onionsat-pcbs/gaia-obc/readme.txt

Kicadben az outline importálása: File -> Import -> Graphics

import scale: 1
dxf defult line width: 0.2mm
dxf defult units: millimetres
place at: x-eld ki
layer: edge cuts
group: kikapcsolva
fix discontinuities: kikapcsolva
