onionsat-pcbs/gaia-obc/outline.dxf

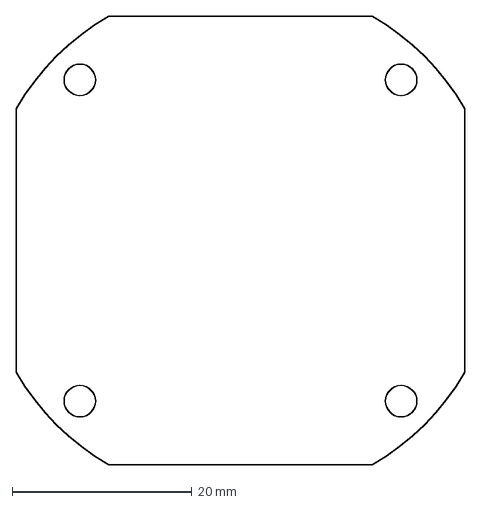
[picture p1: CAD file, 2025-06-25]
outline.dxf
50.0 x 50.0 mm
