onionsat-pcbs/gaia-obc/3dmodels/OLED-SMD_ST7735S.step

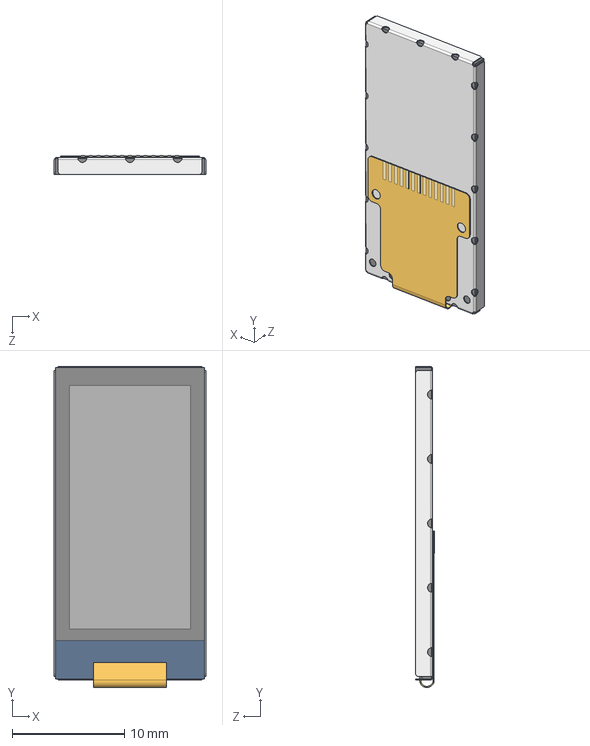
[picture p2: CAD file, 2025-12-01]
3dmodels/OLED-SMD_ST7735S.step
13.5 x 28.6 x 1.65 mm
