onionsat-pcbs/gaia-obc/3dmodels/SMD_16P-L16.0-W16.0-P2.00.step

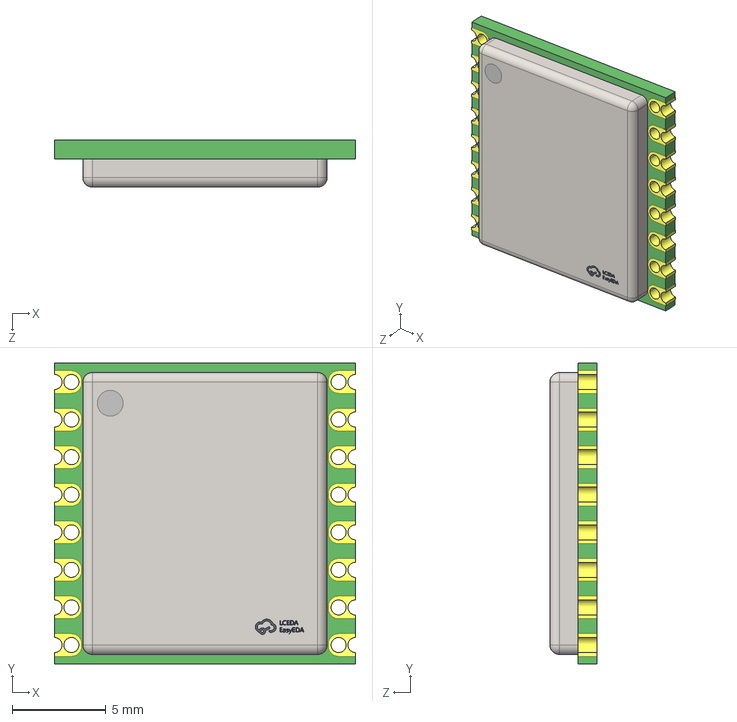
[picture p3: CAD file, 2025-12-01]
3dmodels/SMD_16P-L16.0-W16.0-P2.00.step
16.0 x 16.0 x 2.51 mm
