onionsat-pcbs/gaia-obc/3dmodels/CD-PA1616D.STEP

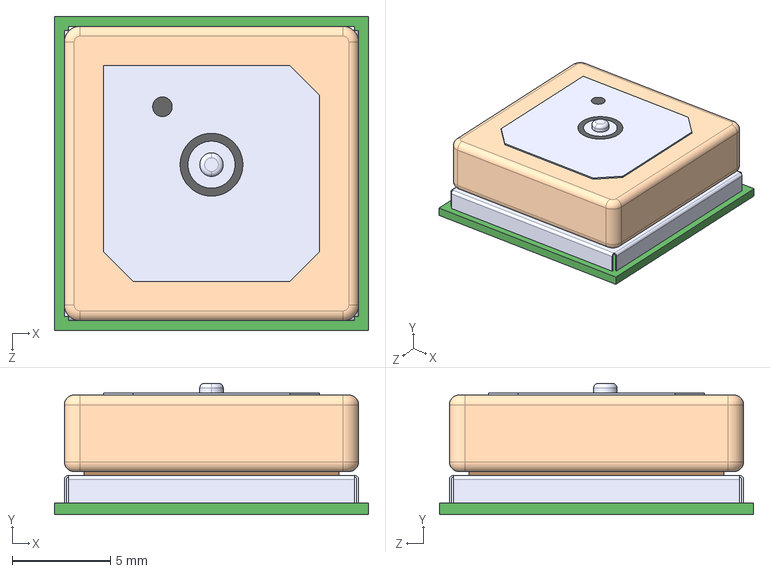
[picture p4: CAD file, 2025-12-01]
3dmodels/CD-PA1616D.STEP
16.0 x 6.70 x 16.0 mm
