onionsat-pcbs/gaia-obc/3dmodels/KEY-SMD_4P-L3.1-W3.1-P2.00-LS4.0.step

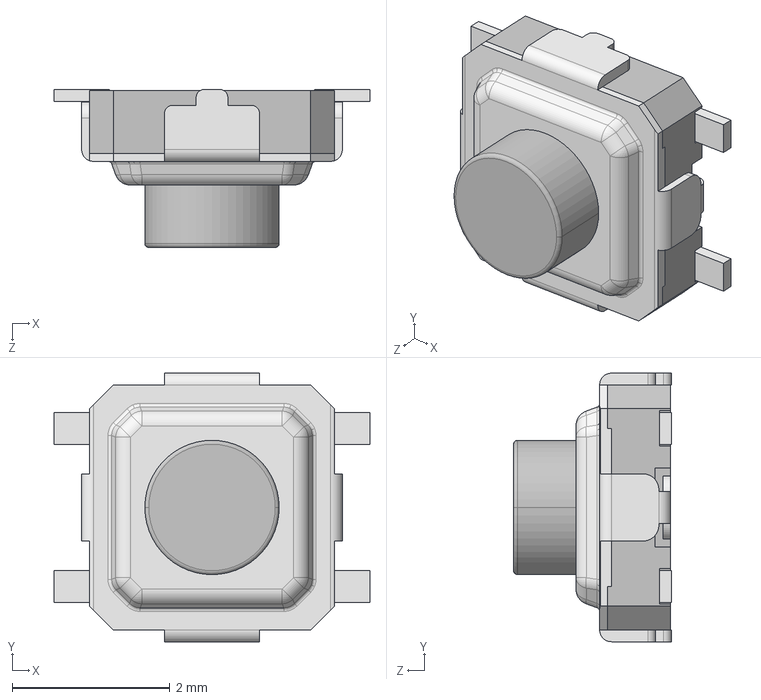
[picture p5: CAD file, 2025-12-01]
3dmodels/KEY-SMD_4P-L3.1-W3.1-P2.00-LS4.0.step
4.00 x 3.40 x 2.00 mm
