onionsat-pcbs/gaia-obc/3dmodels/INA3221.STEP

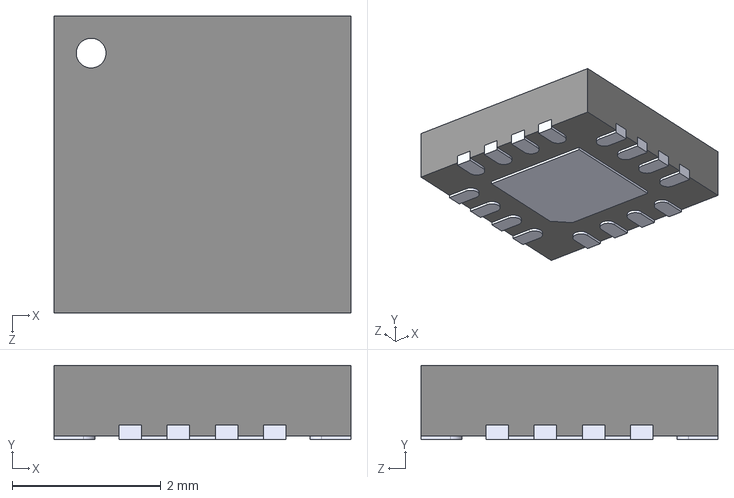
[picture p6: CAD file, 2025-12-01]
3dmodels/INA3221.STEP
4.00 x 1.00 x 4.00 mm
