onionsat-pcbs/gaia-obc/3dmodels/KEY-SMD_L4.0-W3.0-LS4.9.step

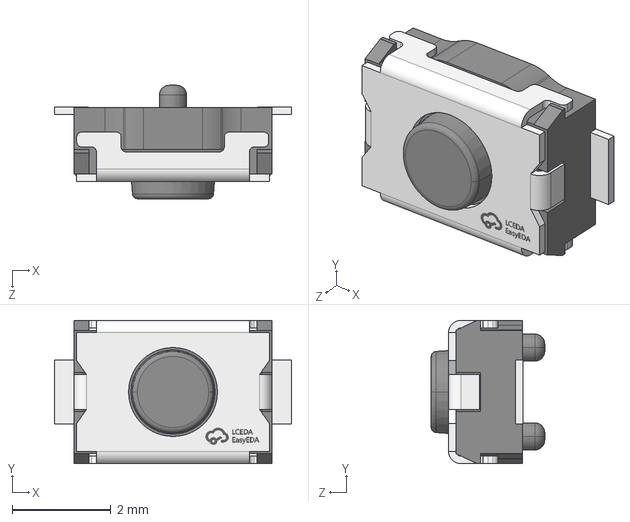
[picture p7: CAD file, 2025-12-01]
3dmodels/KEY-SMD_L4.0-W3.0-LS4.9.step
4.80 x 2.90 x 2.30 mm
