onionsat-pcbs/gaia-obc/3dmodels/ESP32-S3-PICO-1-N8R2.STEP

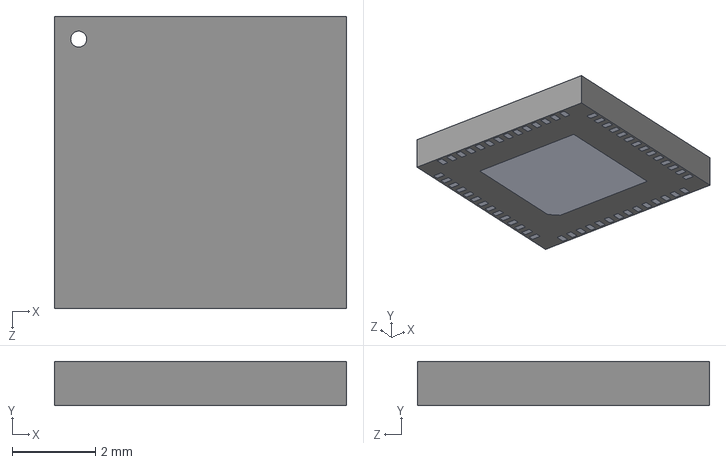
[picture p8: CAD file, 2025-12-01]
3dmodels/ESP32-S3-PICO-1-N8R2.STEP
7.00 x 1.06 x 7.00 mm
