onionsat-pcbs/gaia-obc/3dmodels/SW-SMD_MS-22D28-G020.step

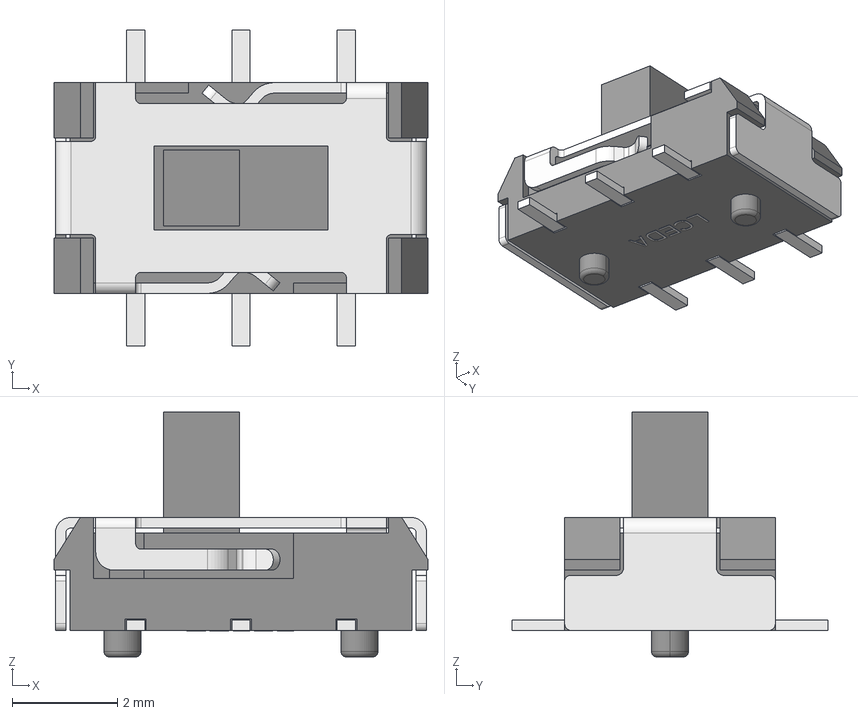
[picture p9: CAD file, 2025-12-01]
3dmodels/SW-SMD_MS-22D28-G020.step
7.10 x 6.00 x 4.65 mm
