onionsat-pcbs/gaia-obc/3dmodels/RFM95W-868S2.STEP

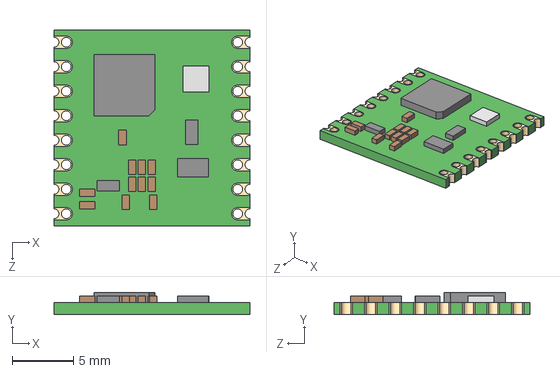
[picture p10: CAD file, 2025-12-01]
3dmodels/RFM95W-868S2.STEP
16.0 x 1.80 x 16.0 mm
