onionsat-pcbs/gaia-obc/3dmodels/antenna.step

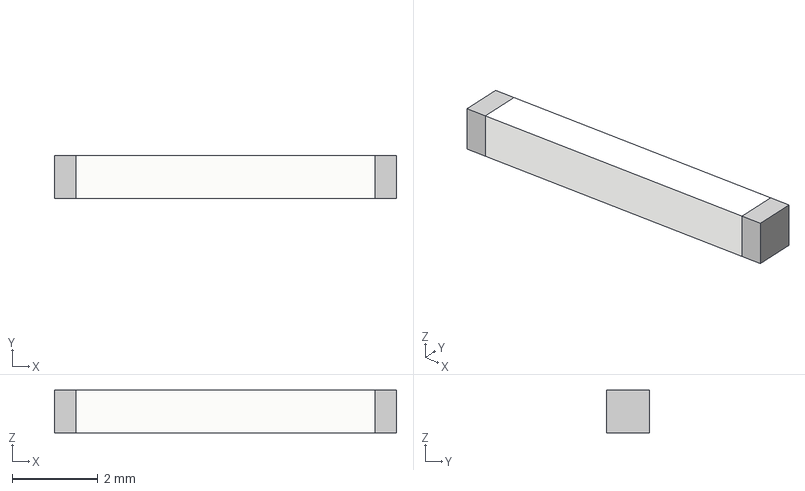
[picture p11: CAD file, 2025-12-01]
3dmodels/antenna.step
8.00 x 1.00 x 1.00 mm
