onionsat-pcbs/gaia-obc/3dmodels/BUZ-SMD_3P-L5.0-W5.0-H2.0-P3.50.step

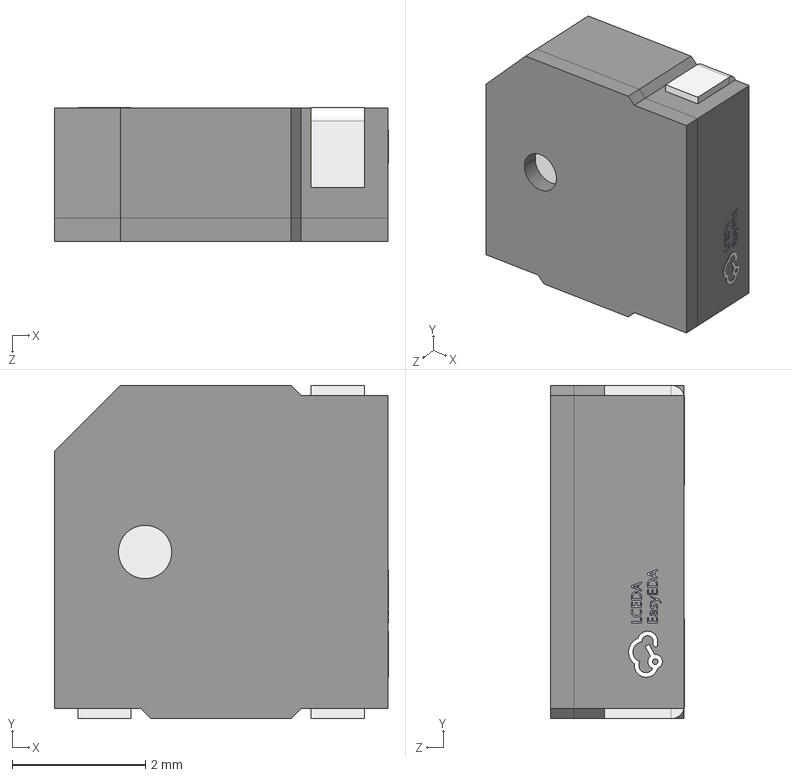
[picture p12: CAD file, 2025-12-01]
3dmodels/BUZ-SMD_3P-L5.0-W5.0-H2.0-P3.50.step
5.01 x 5.00 x 2.01 mm
