onionsat-pcbs/gaia-obc/3dmodels/BME280.STEP

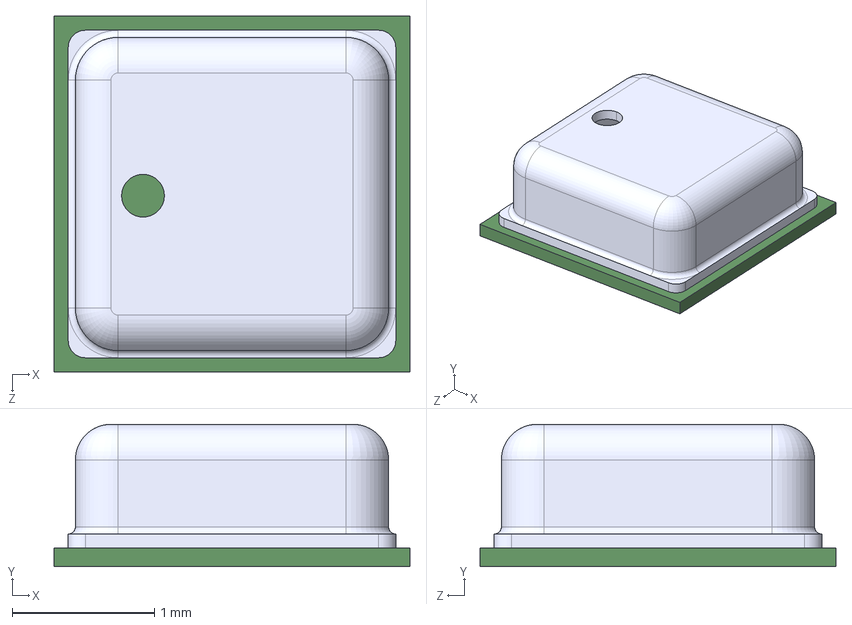
[picture p13: CAD file, 2025-12-01]
3dmodels/BME280.STEP
2.50 x 1.00 x 2.50 mm
