onionsat-pcbs/gaia-obc/3dmodels/USB4216-03-A.stp

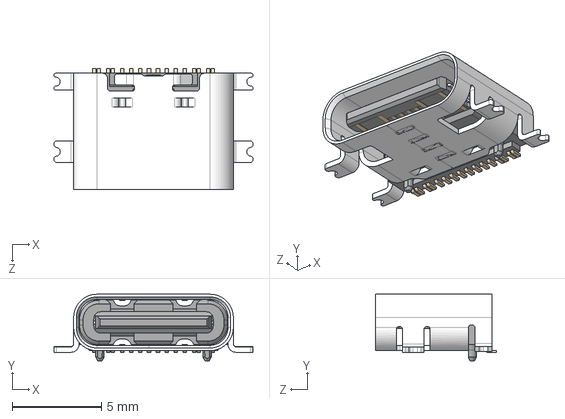
[picture p14: CAD file, 2025-12-01]
3dmodels/USB4216-03-A.stp
11.1 x 3.73 x 6.75 mm
USB4216 Shell
USB4216 Housing&Terminal
