onionsat-pcbs/gaia-obc/3dmodels/TFM201610GHM-1R0MTAA.stp

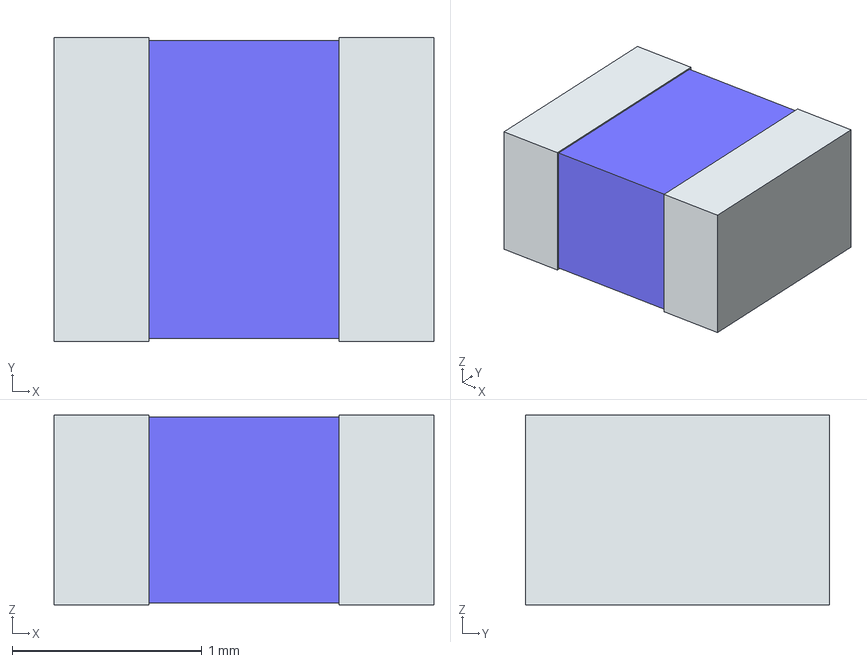
[picture p15: CAD file, 2026-02-01]
3dmodels/TFM201610GHM-1R0MTAA.stp
2.00 x 1.60 x 1.00 mm
term1
term2
