onionsat-pcbs/gaia-obc/3dmodels/MAX77816AEWP_T.step

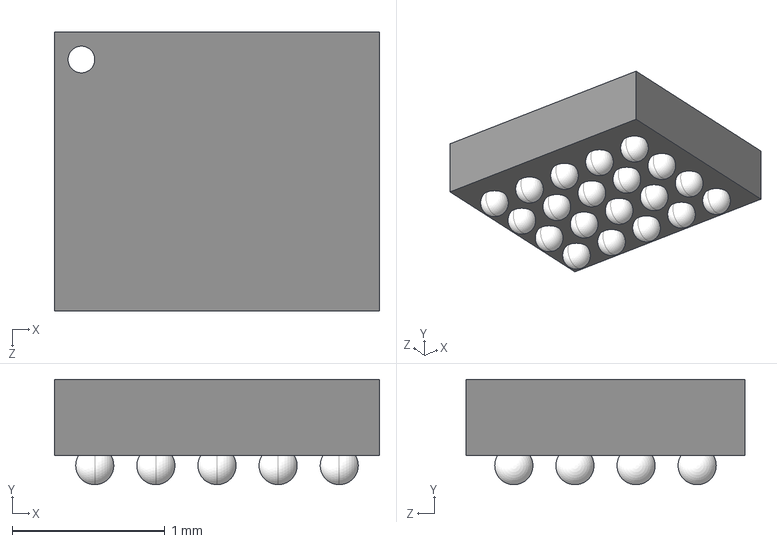
[picture p16: CAD file, 2025-12-30]
3dmodels/MAX77816AEWP_T.step
2.13 x 0.69 x 1.83 mm
