onionsat-pcbs/gaia-obc/3dmodels/MAX17048G-T10.STEP

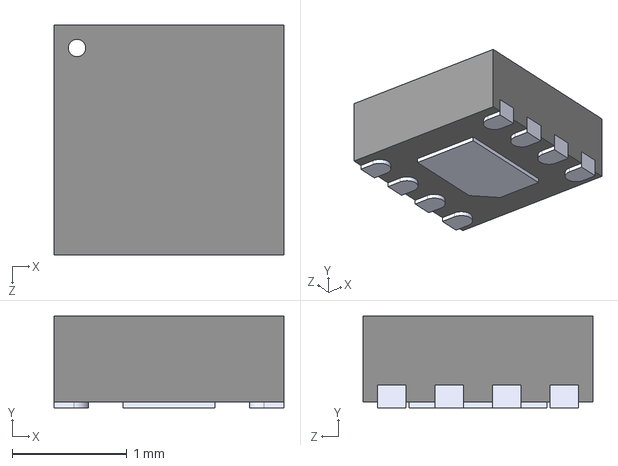
[picture p17: CAD file, 2025-12-01]
3dmodels/MAX17048G-T10.STEP
2.00 x 0.8 x 2.00 mm
