onionsat-pcbs/gaia-obc/schematics/gaia_obc_schematic_rev1.4.pdf

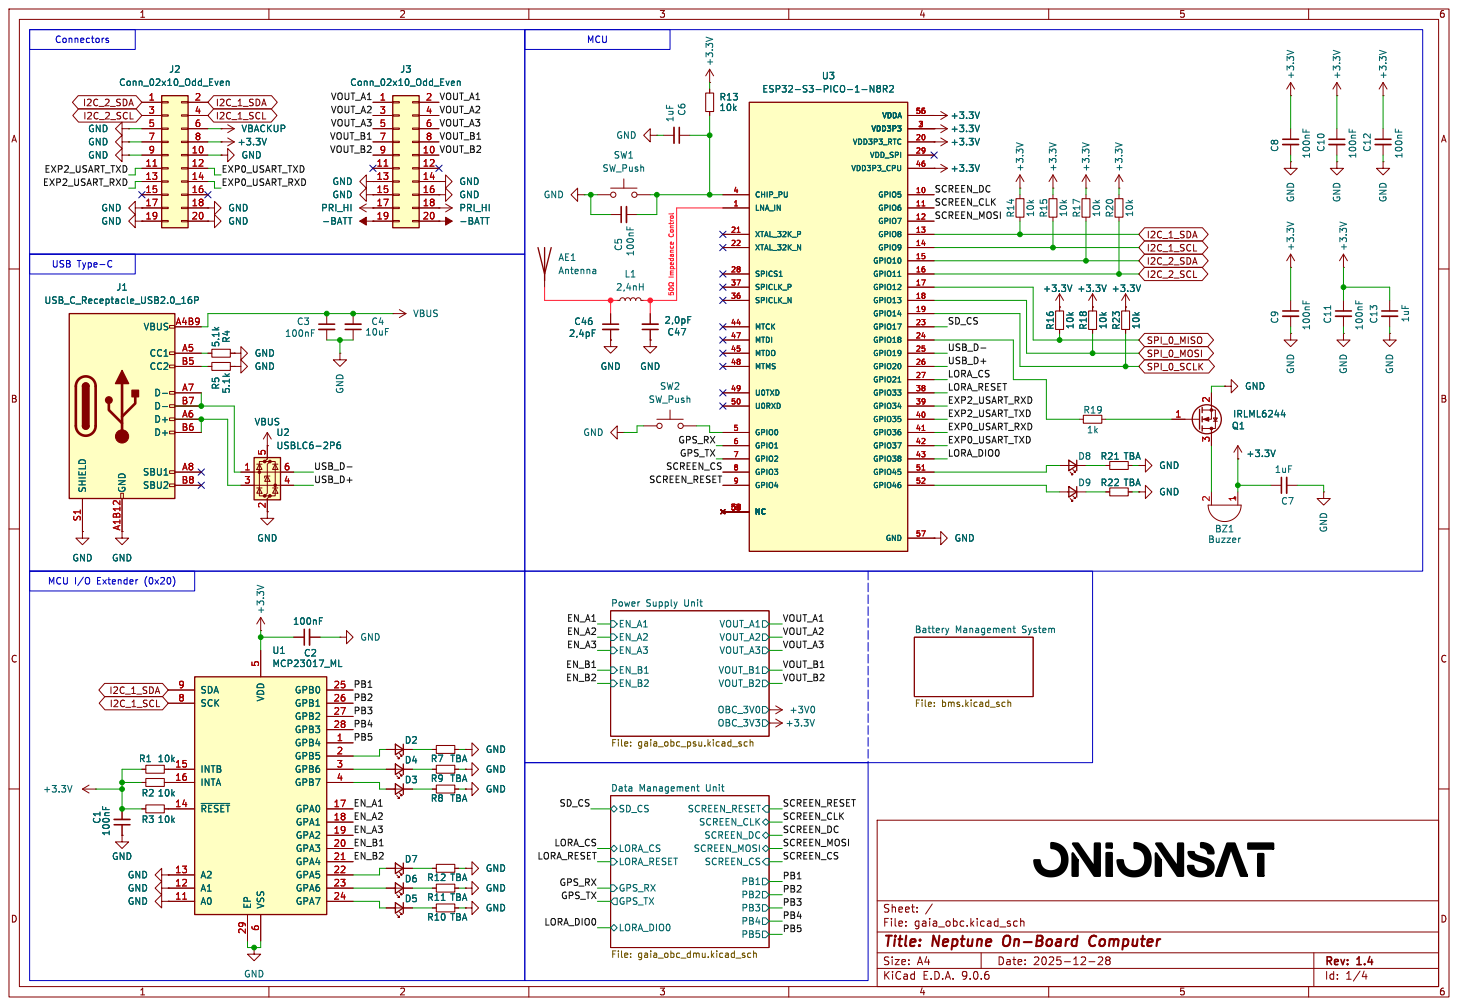
[picture p18: page 1]

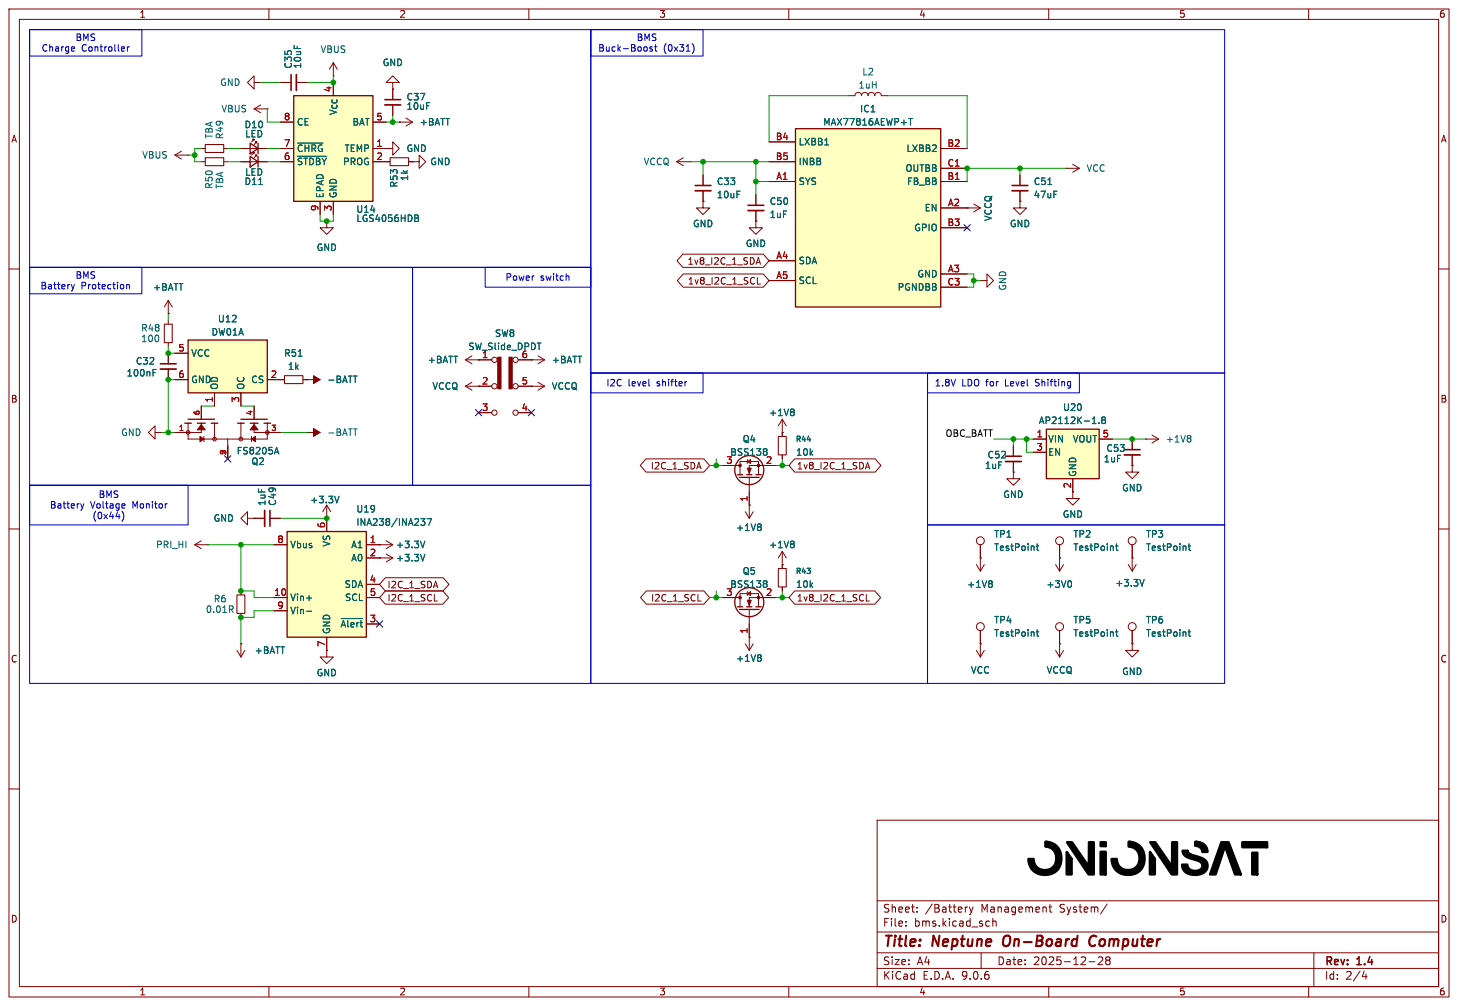
[picture p19: page 2]

+BATT GND R531k C35 10uF TBA R49 GND

3 BAT 5 TEMP 1 PROG 2 +BATT GND R531k C35 10uF D10

7 A1 1 A0 2 SDA 4 SCL 5 ~{Alert}3 GND

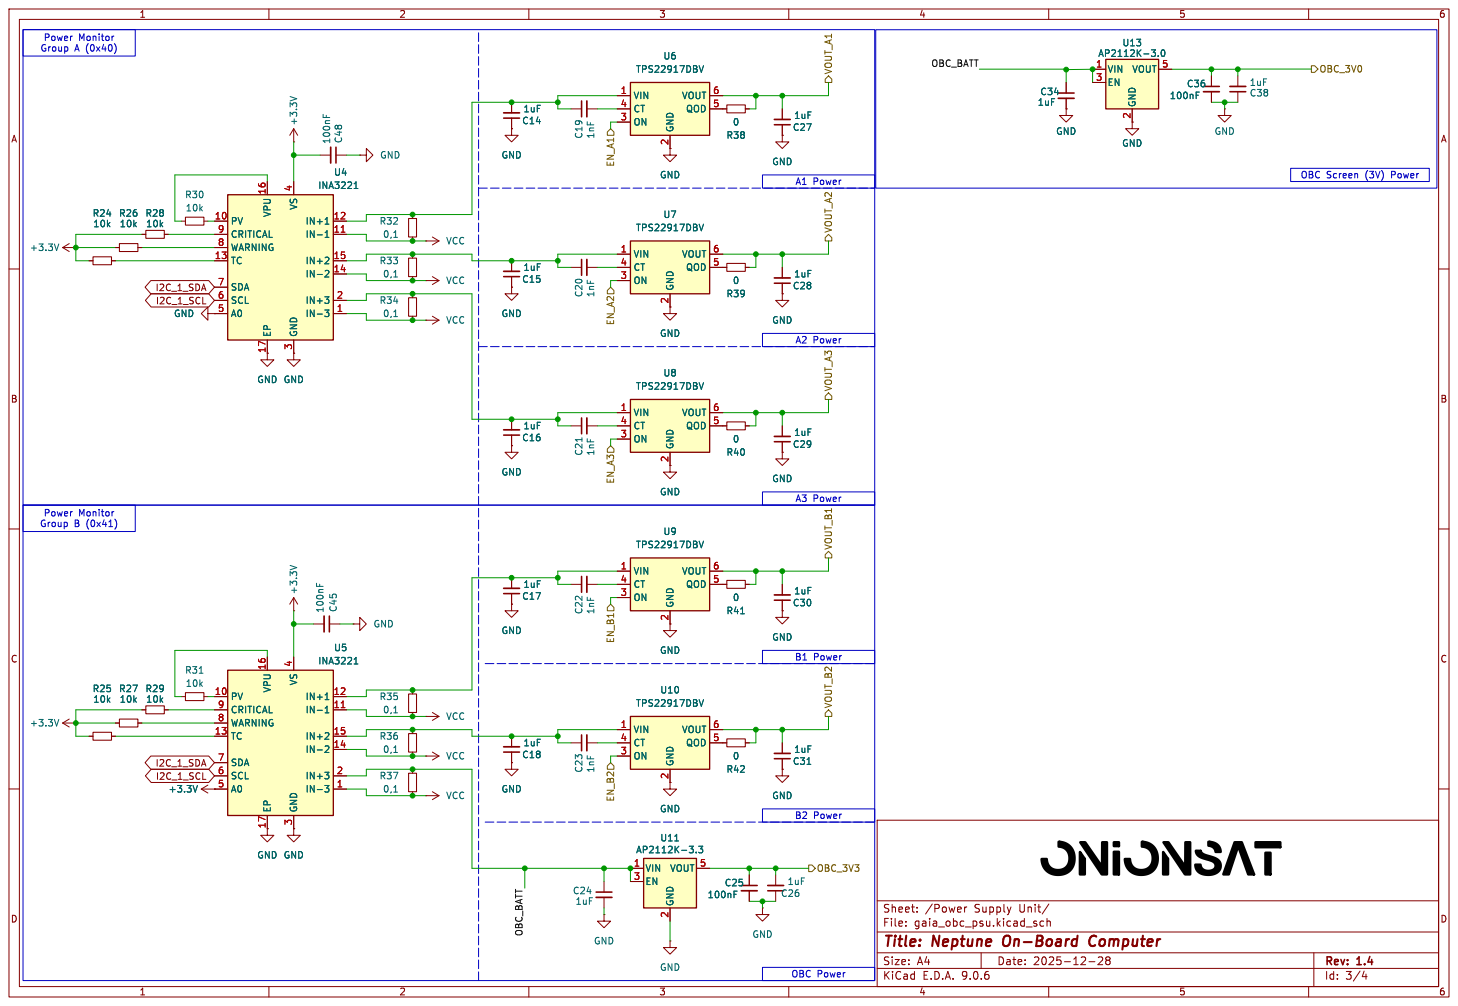
[picture p20: page 3]

B2 Power OBC Power B1 Power Power Monitor Group B (0x41)

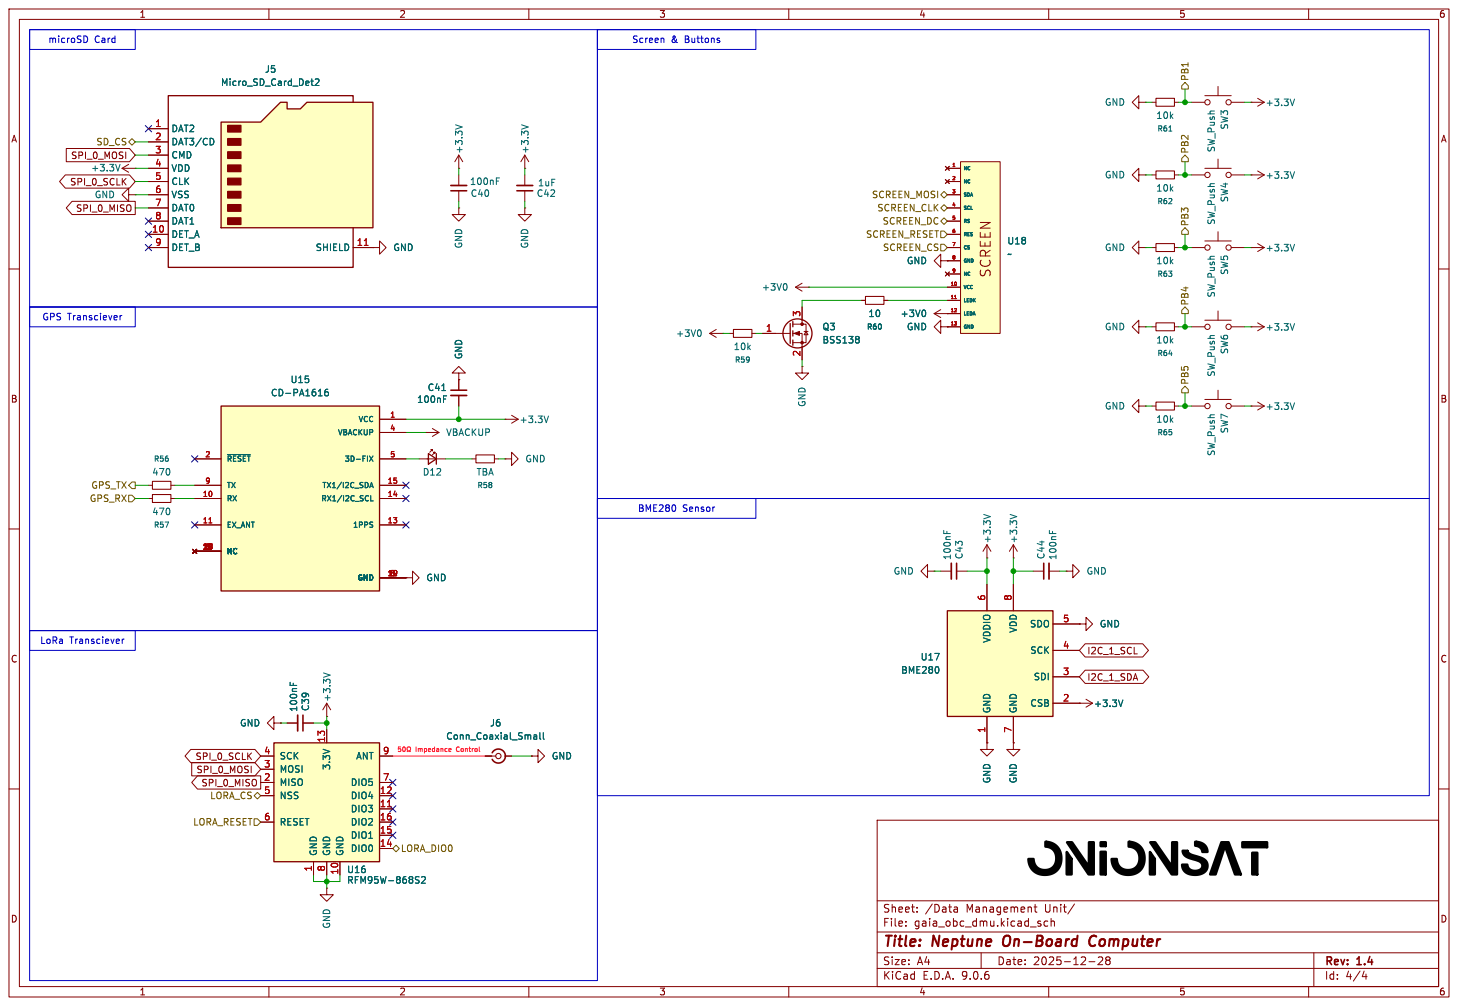
[picture p21: page 4]
