onionsat-pcbs/gaia-obc/schematics/gaia_obc_schematic_rev1.3.pdf

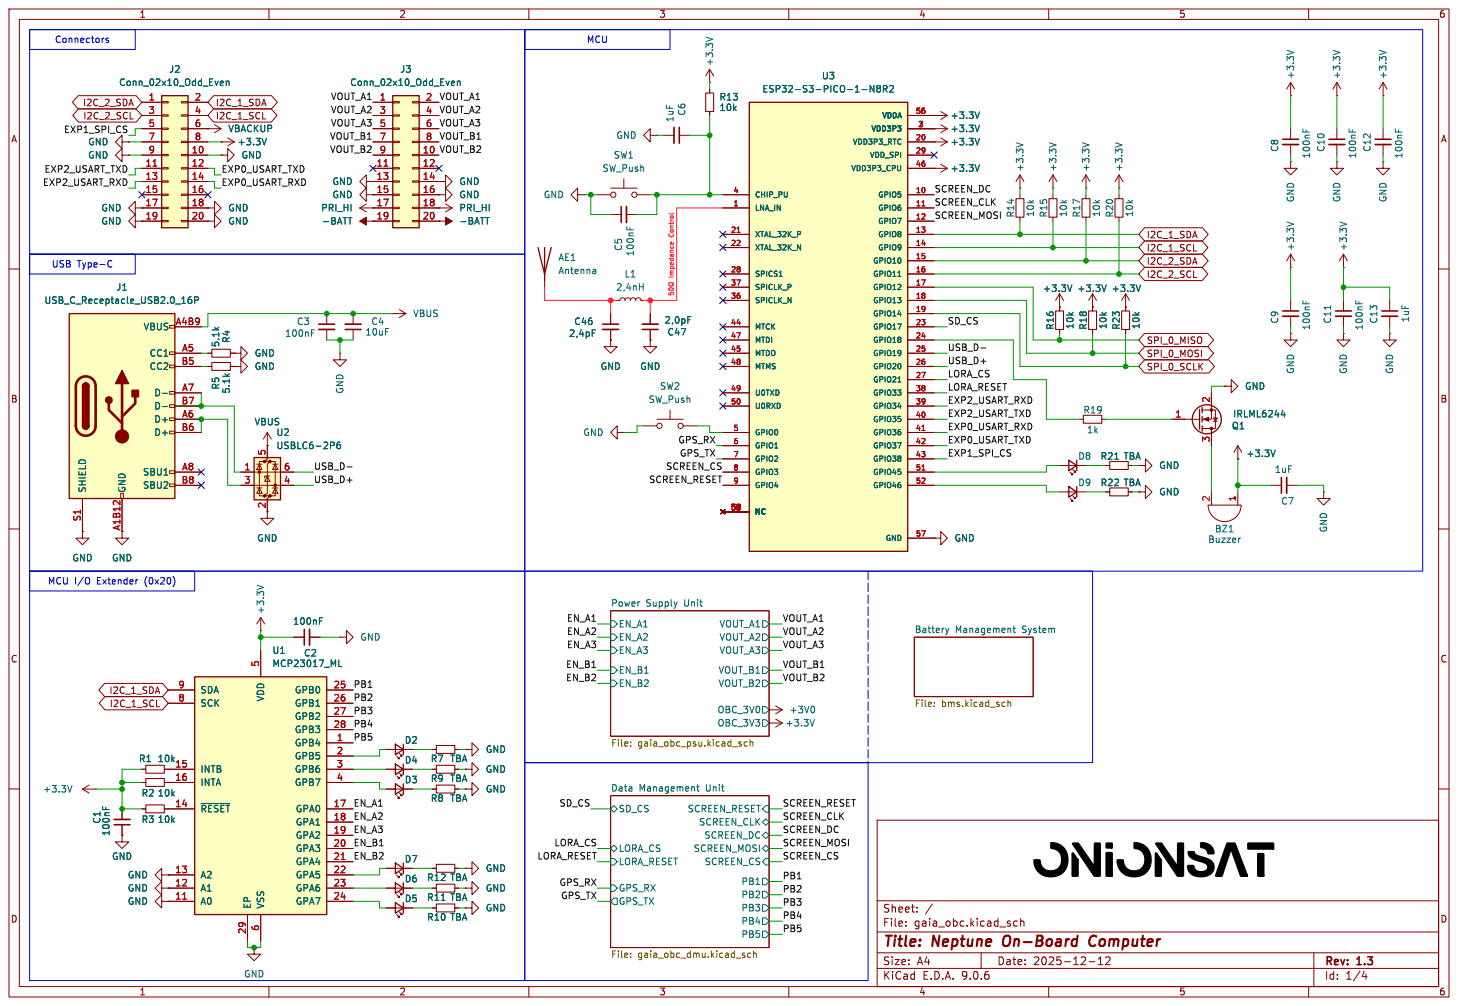
[picture p22: page 1]

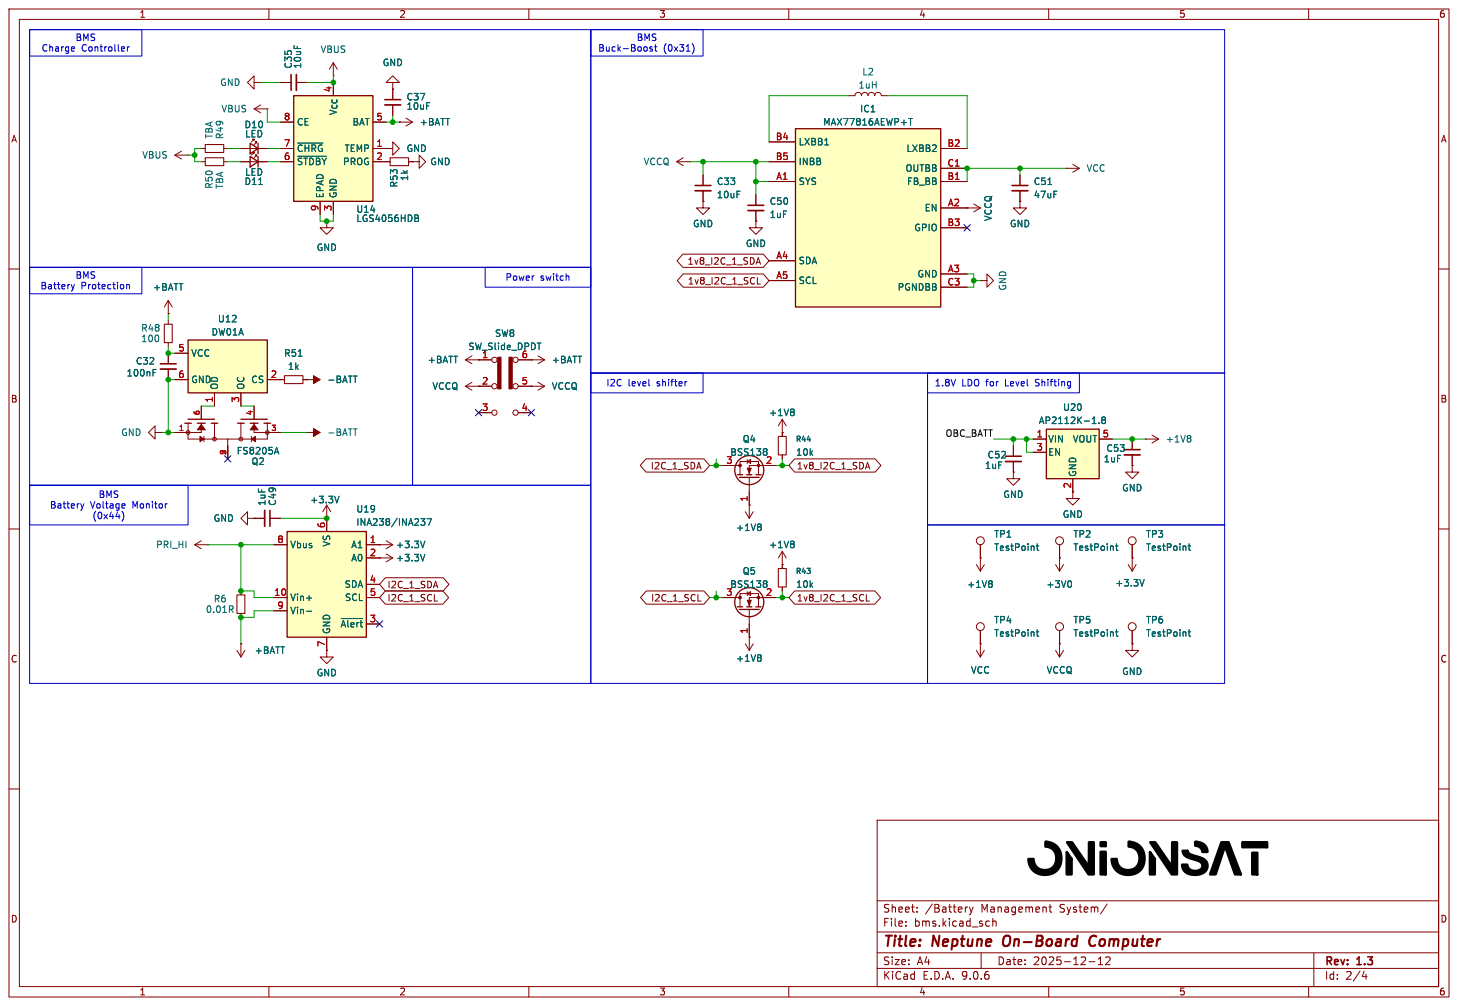
[picture p23: page 2]

1.8V LDO for Level Shifting Power switch BMS

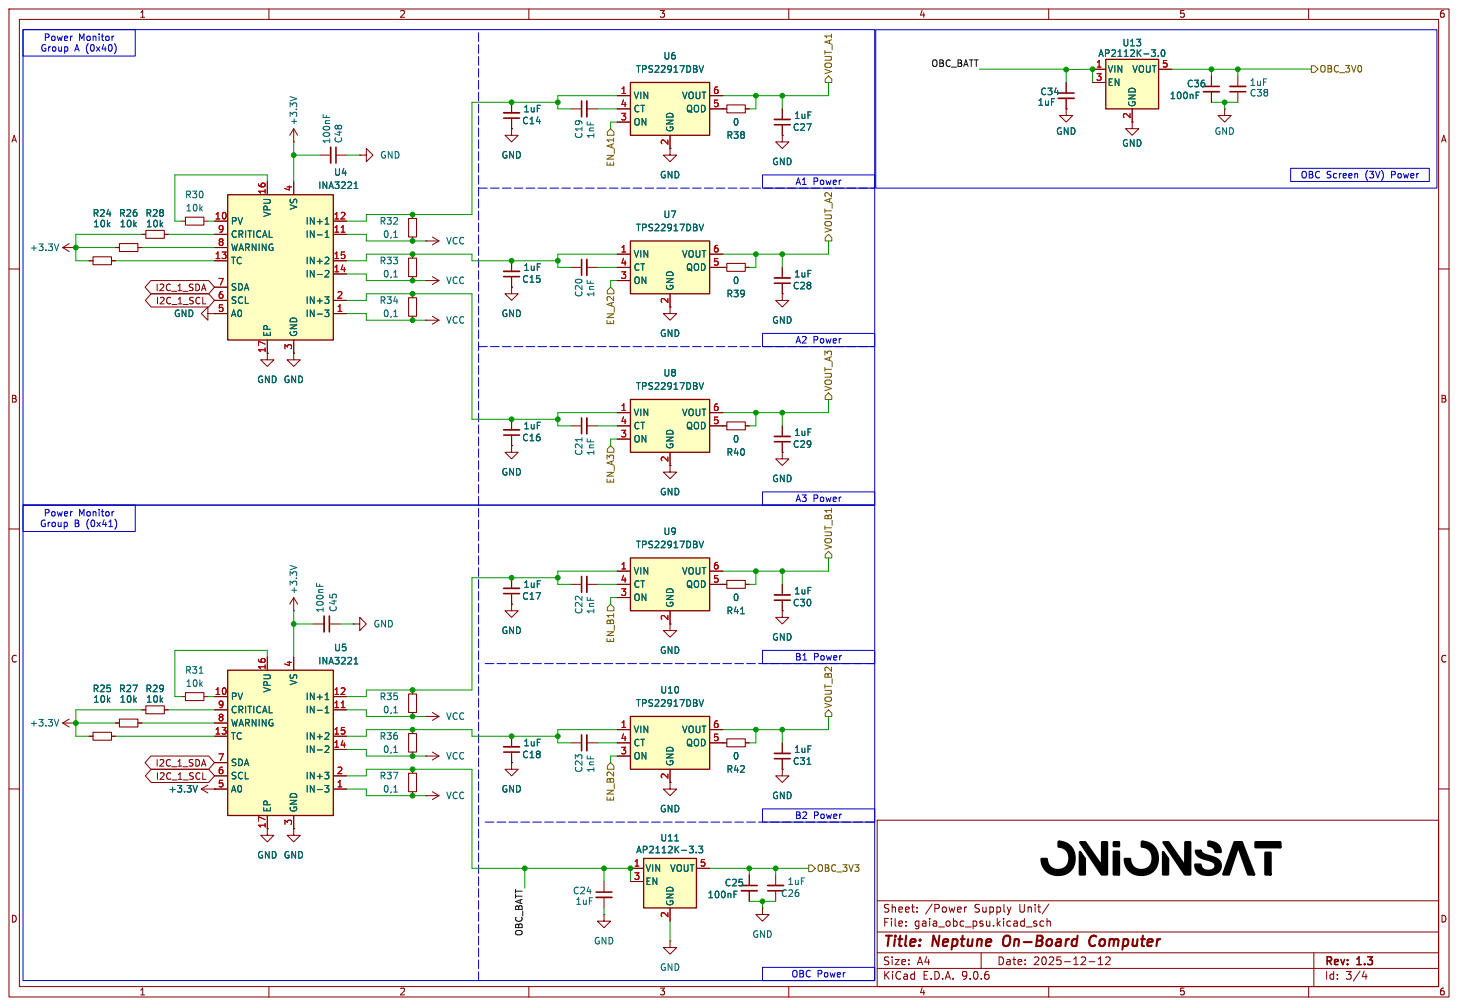
[picture p24: page 3]

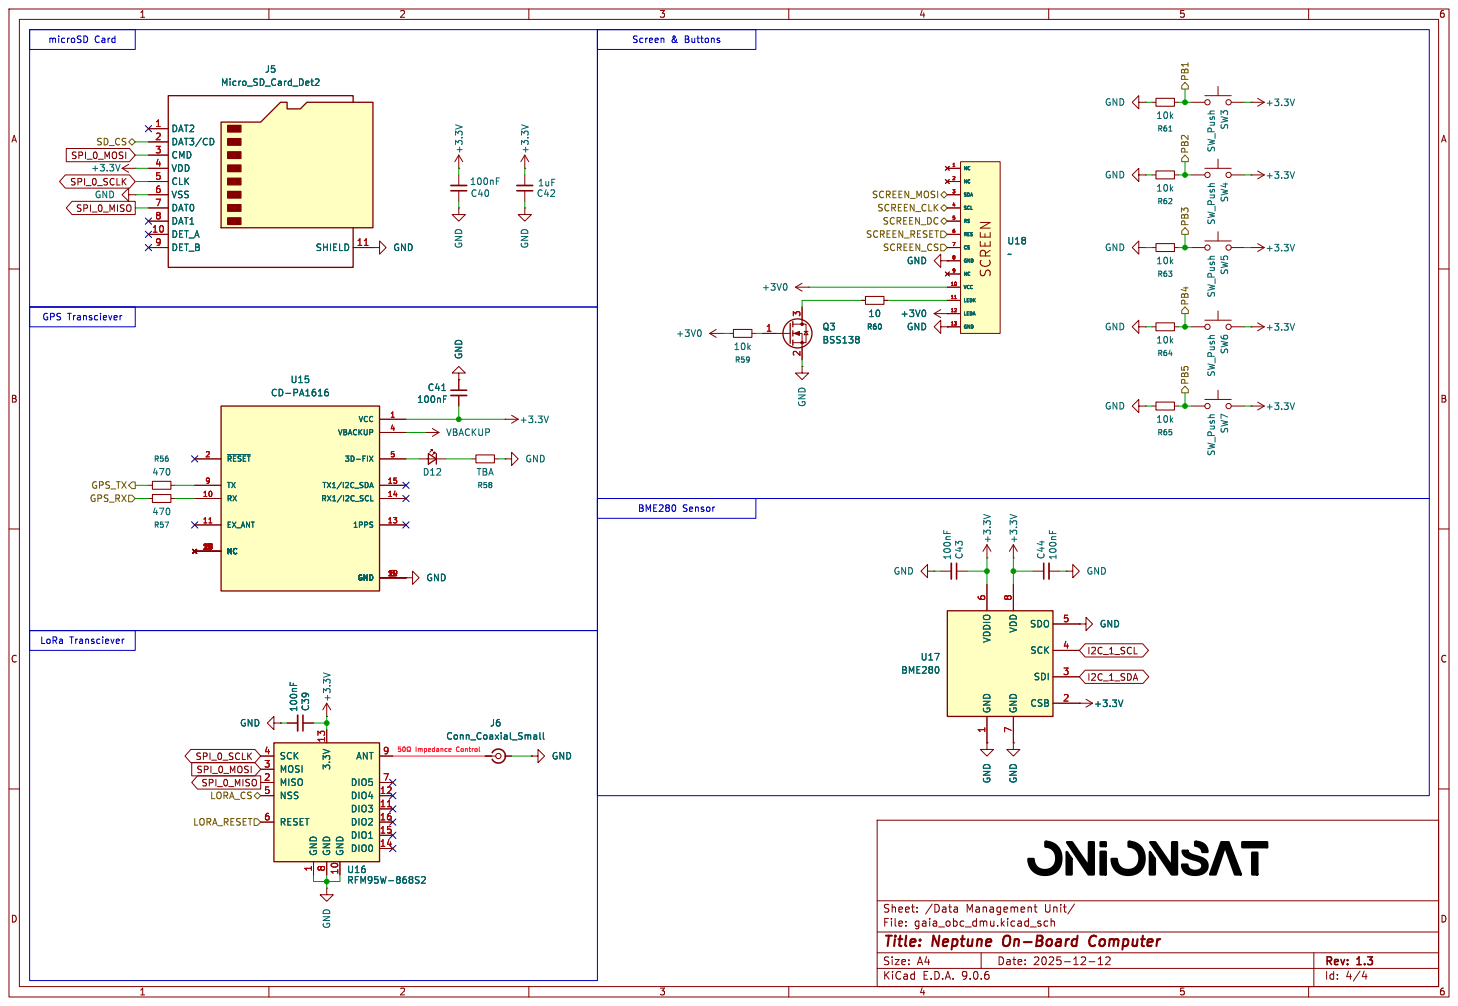
[picture p25: page 4]

þÿ50©Impedance Control GND
