onionsat-pcbs/gaia-obc/schematics/gaia_obc_schematic_rev1.2.pdf

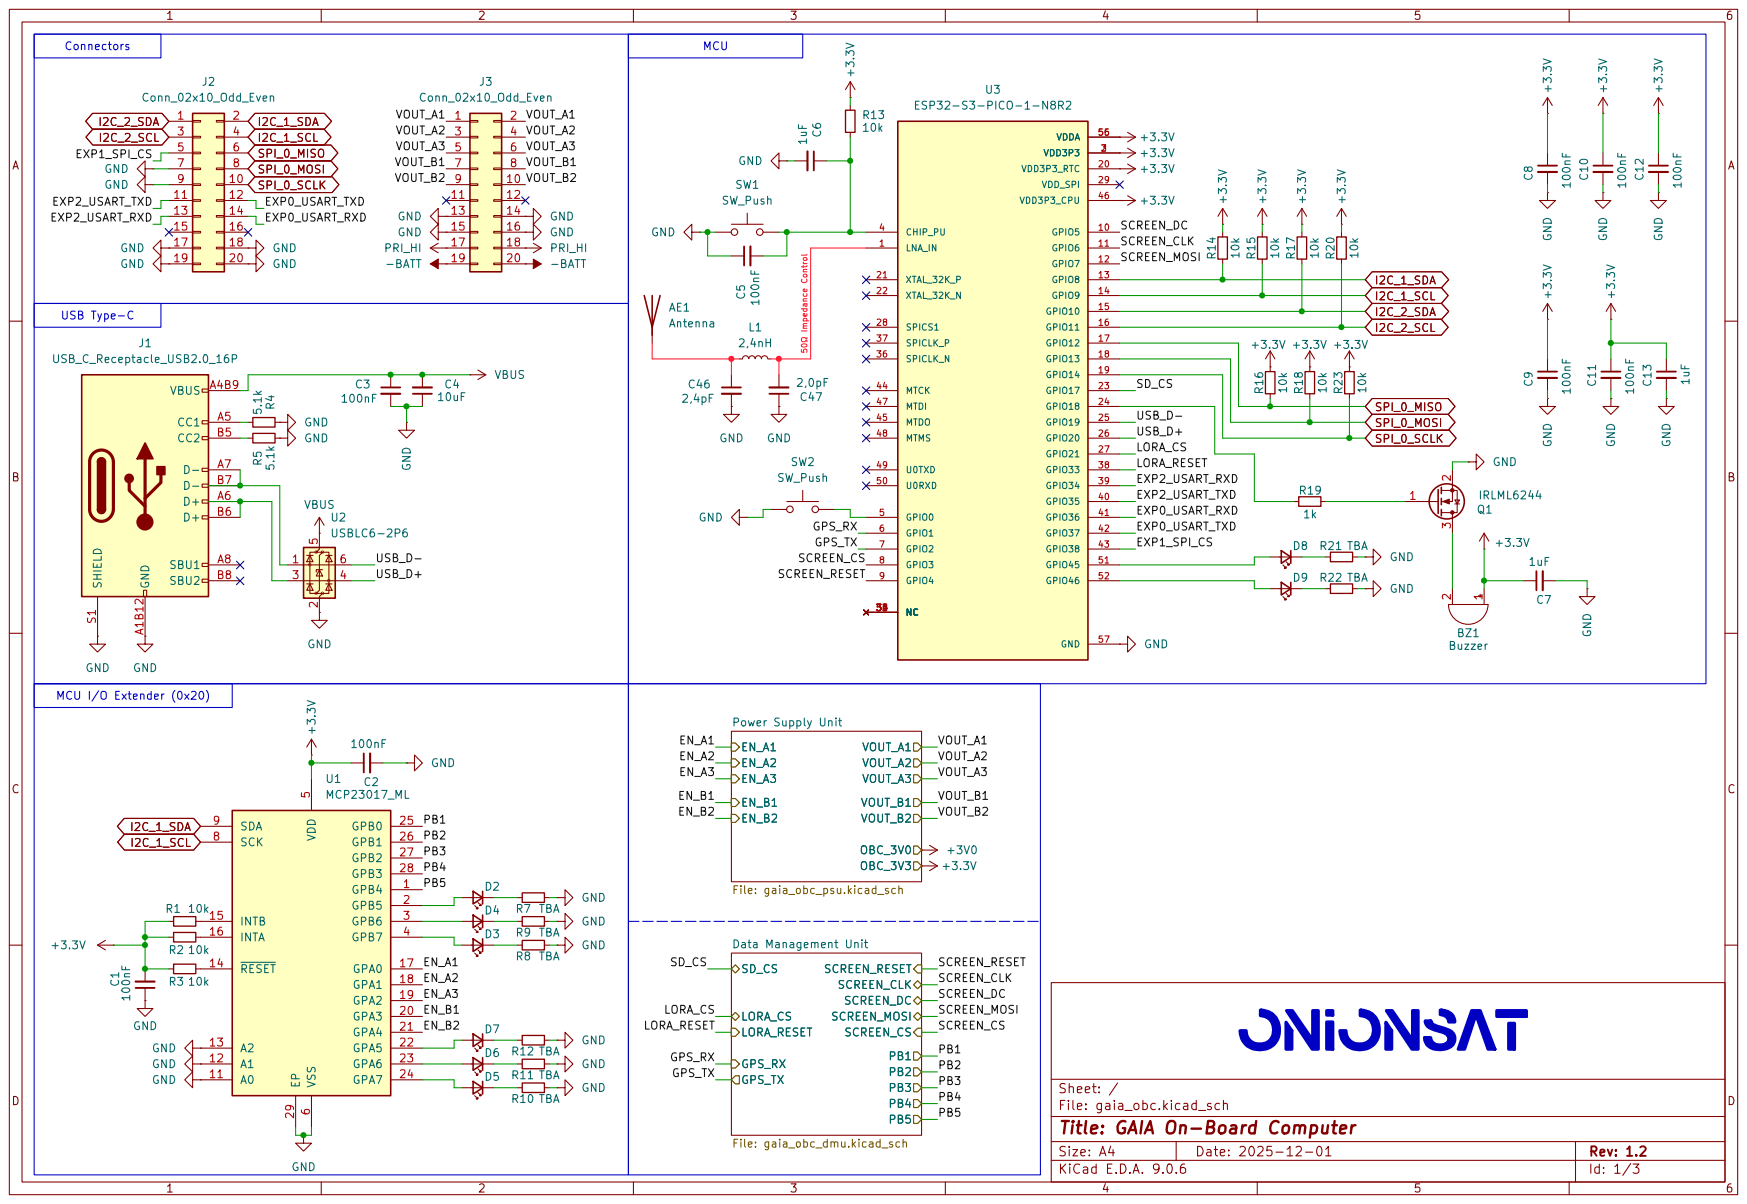
[picture p26: page 1]

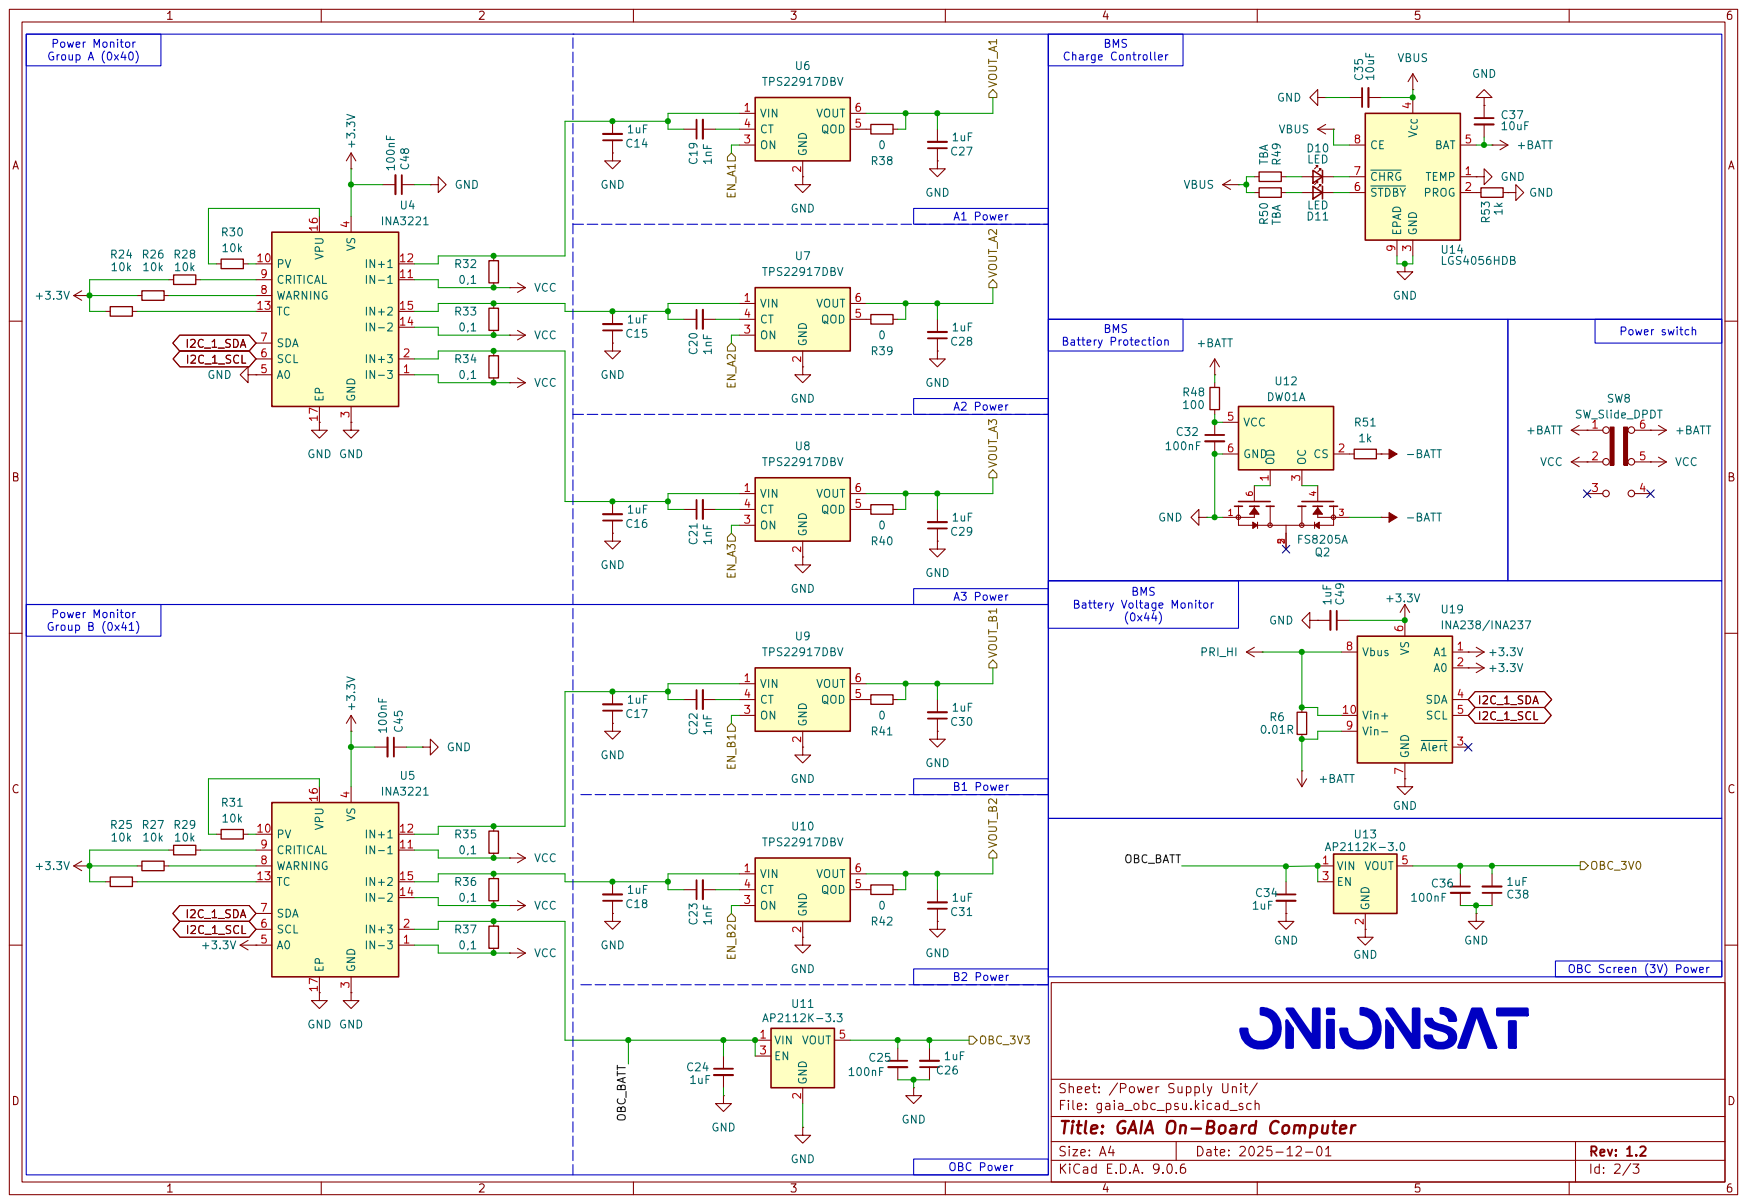
[picture p27: page 2]

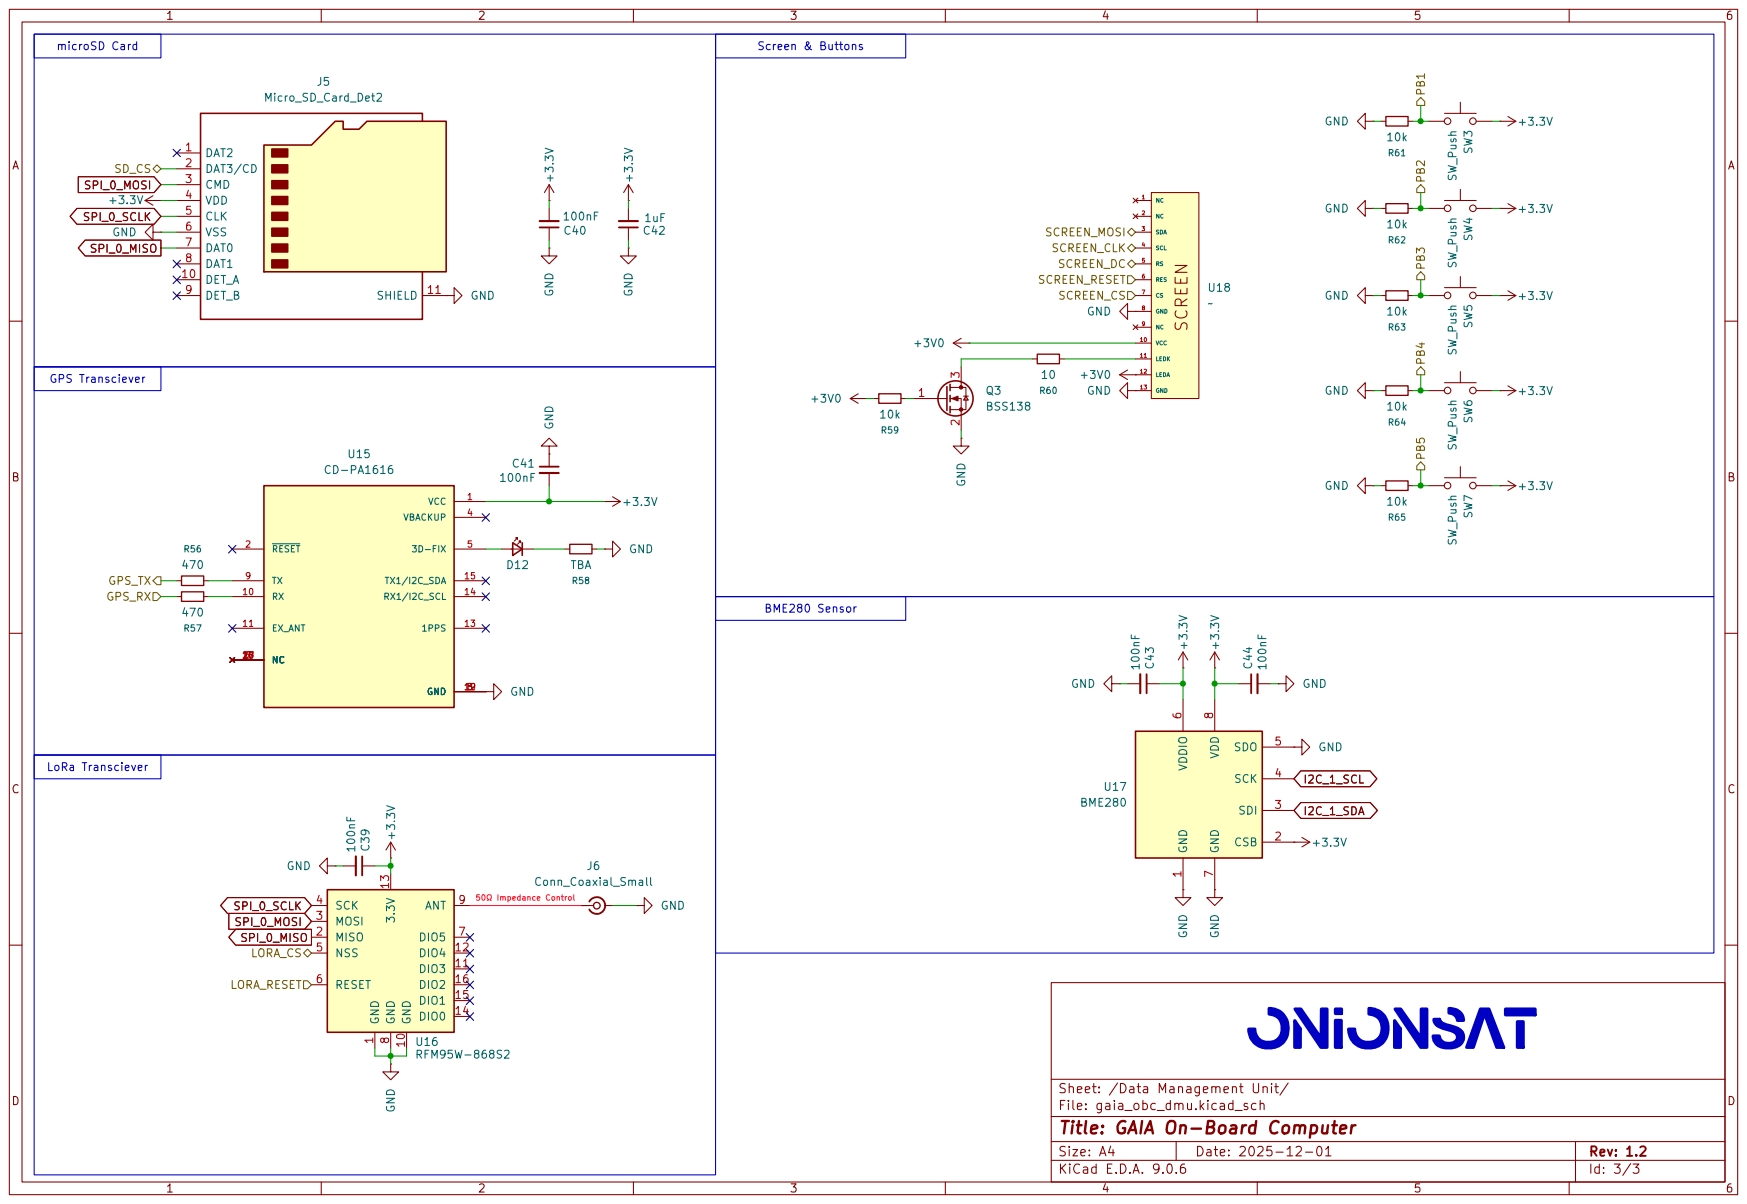
[picture p28: page 3]
