onionsat-pcbs/gaia-obc/schematics/gaia_obc_schematic_rev1.1.pdf

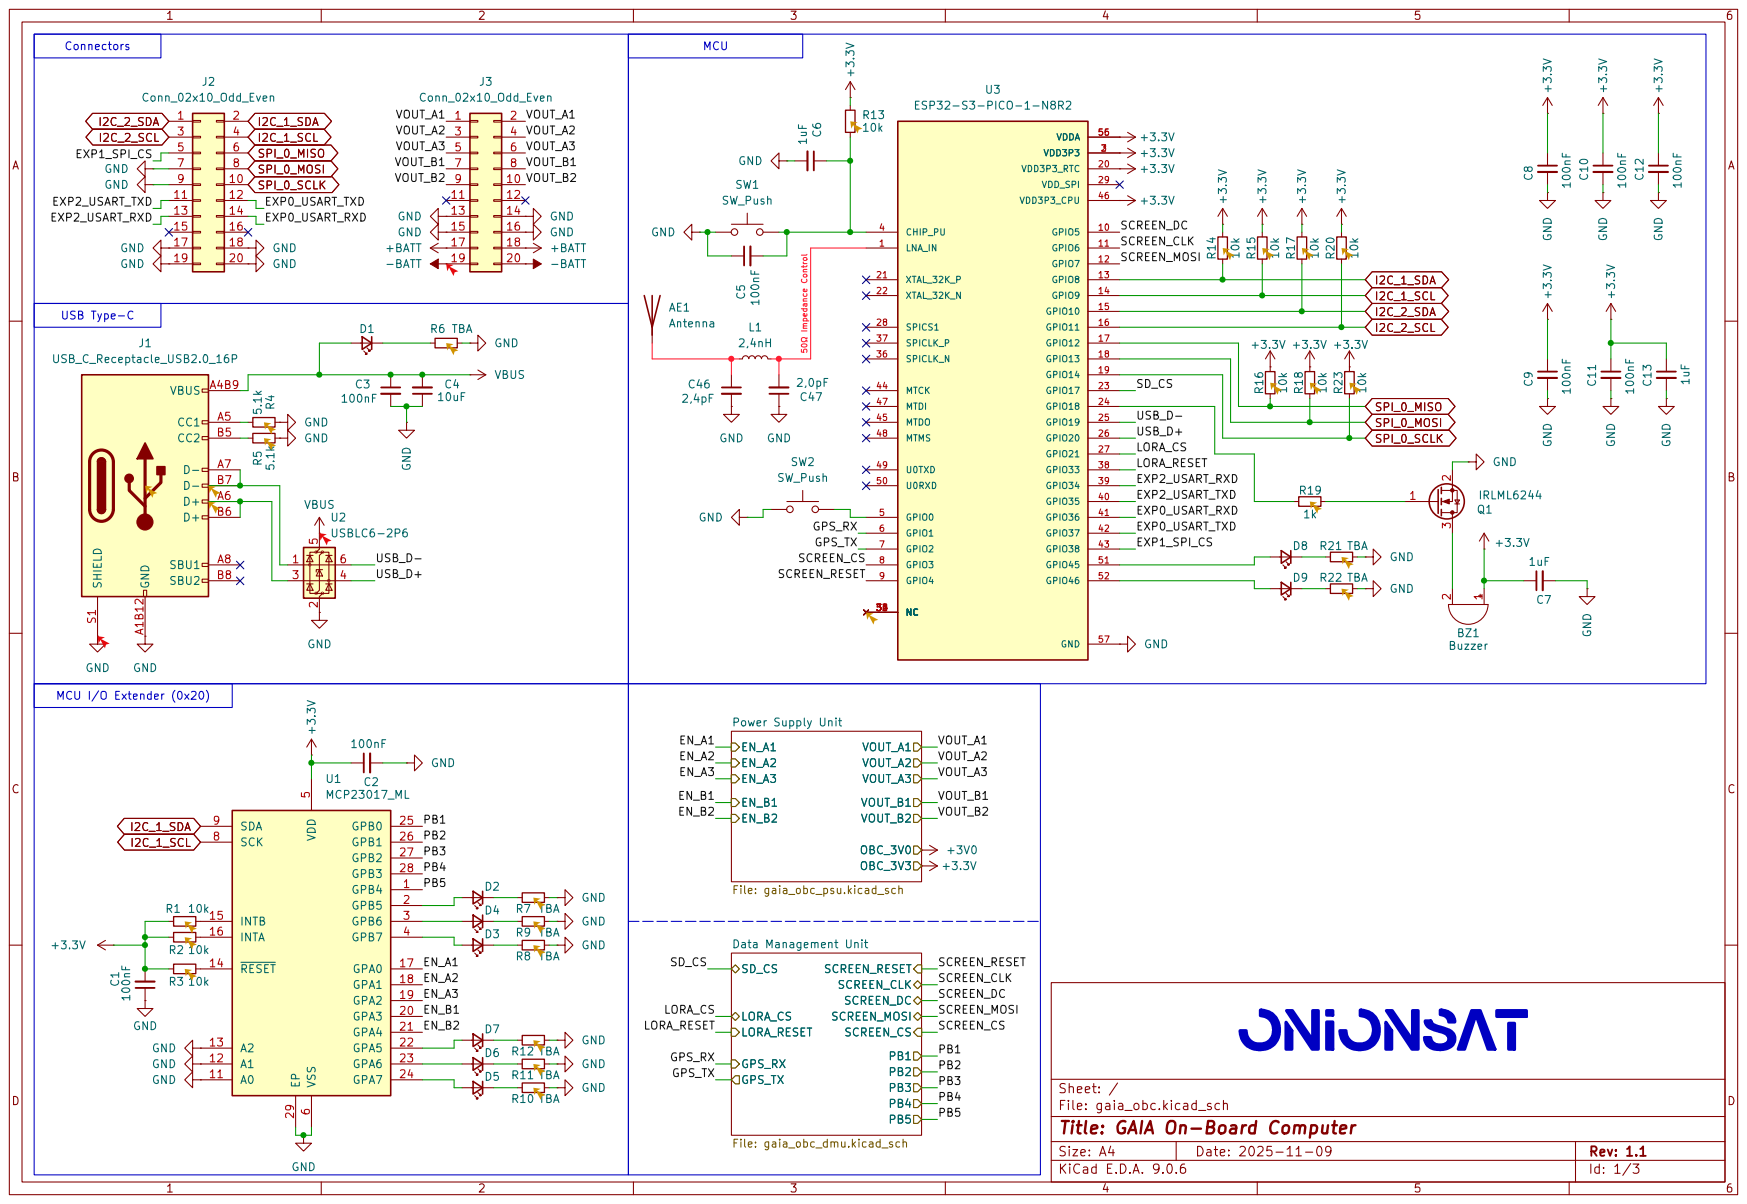
[picture p29: page 1]

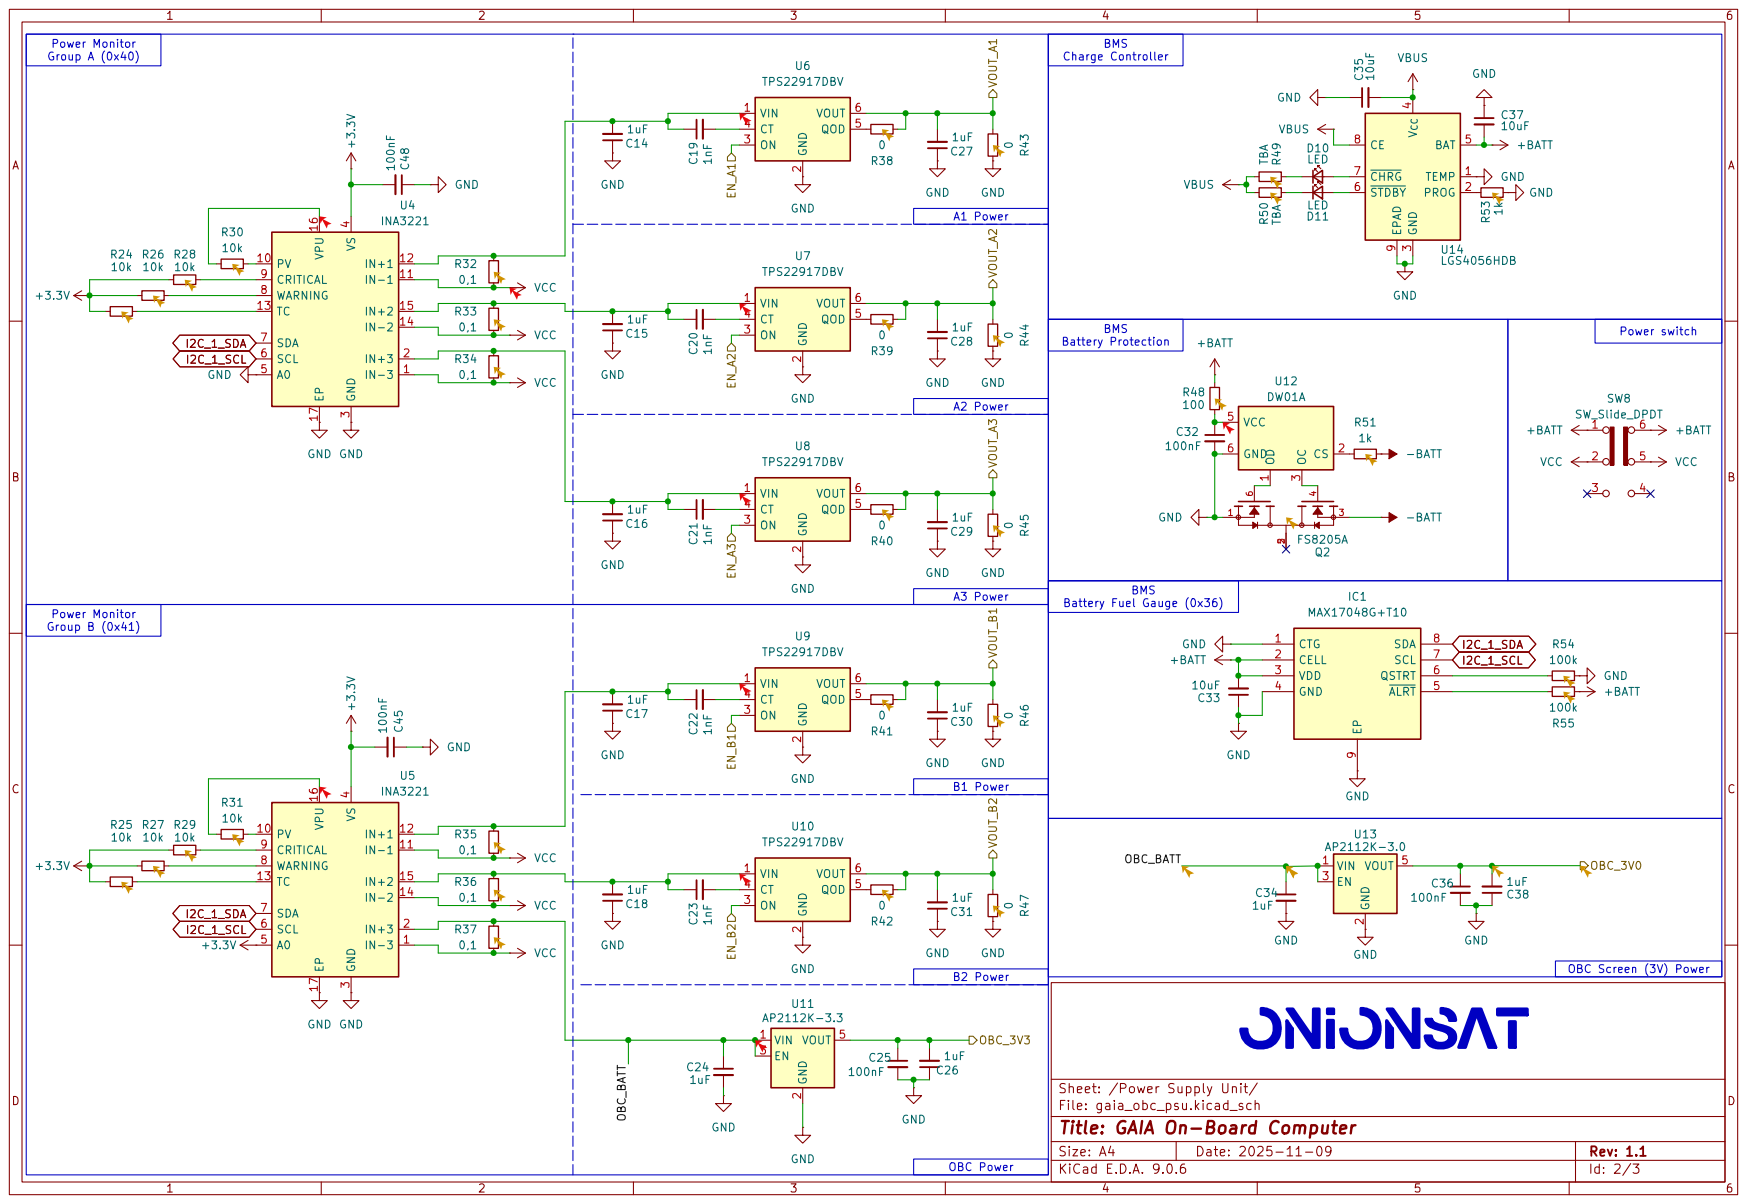
[picture p30: page 2]

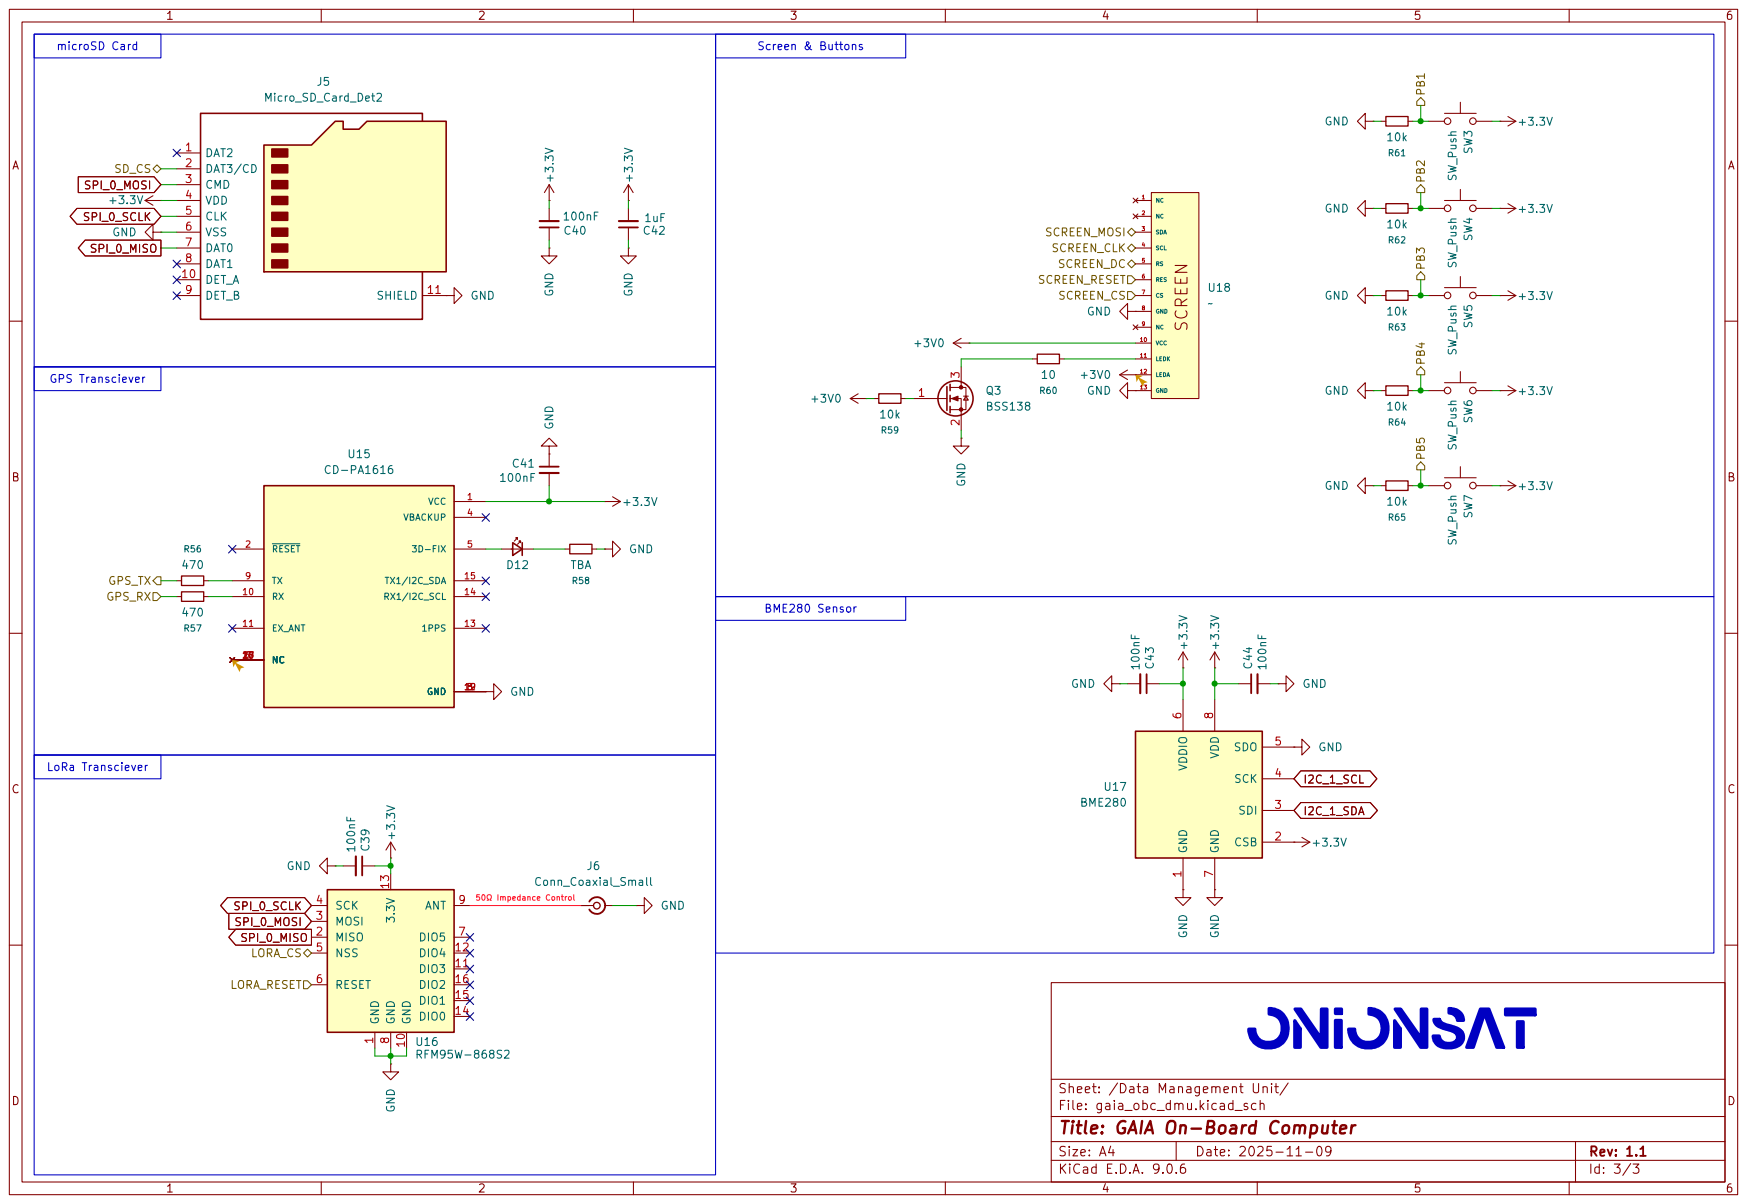
[picture p31: page 3]
