onionsat-pcbs/gaia-obc/schematics/gaia_obc_schematic_rev1.0.pdf

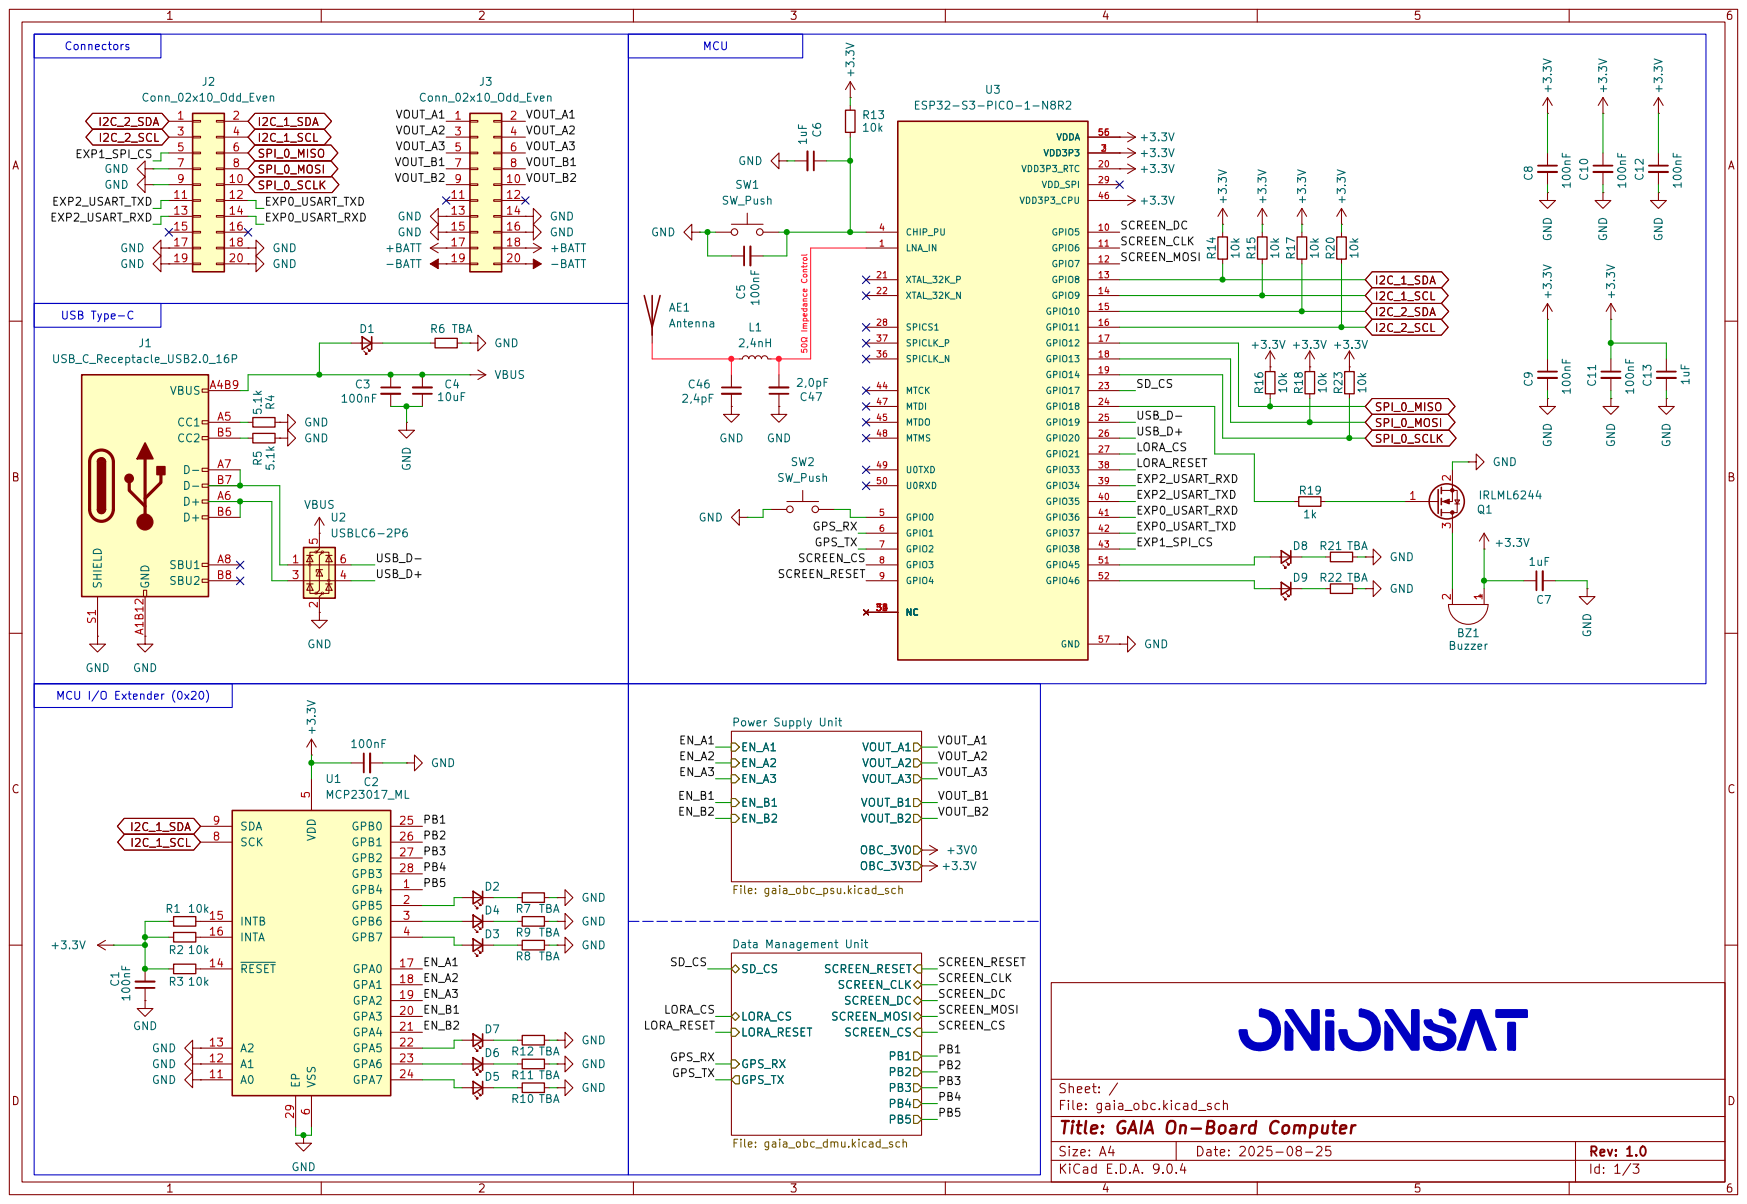
[picture p32: page 1]

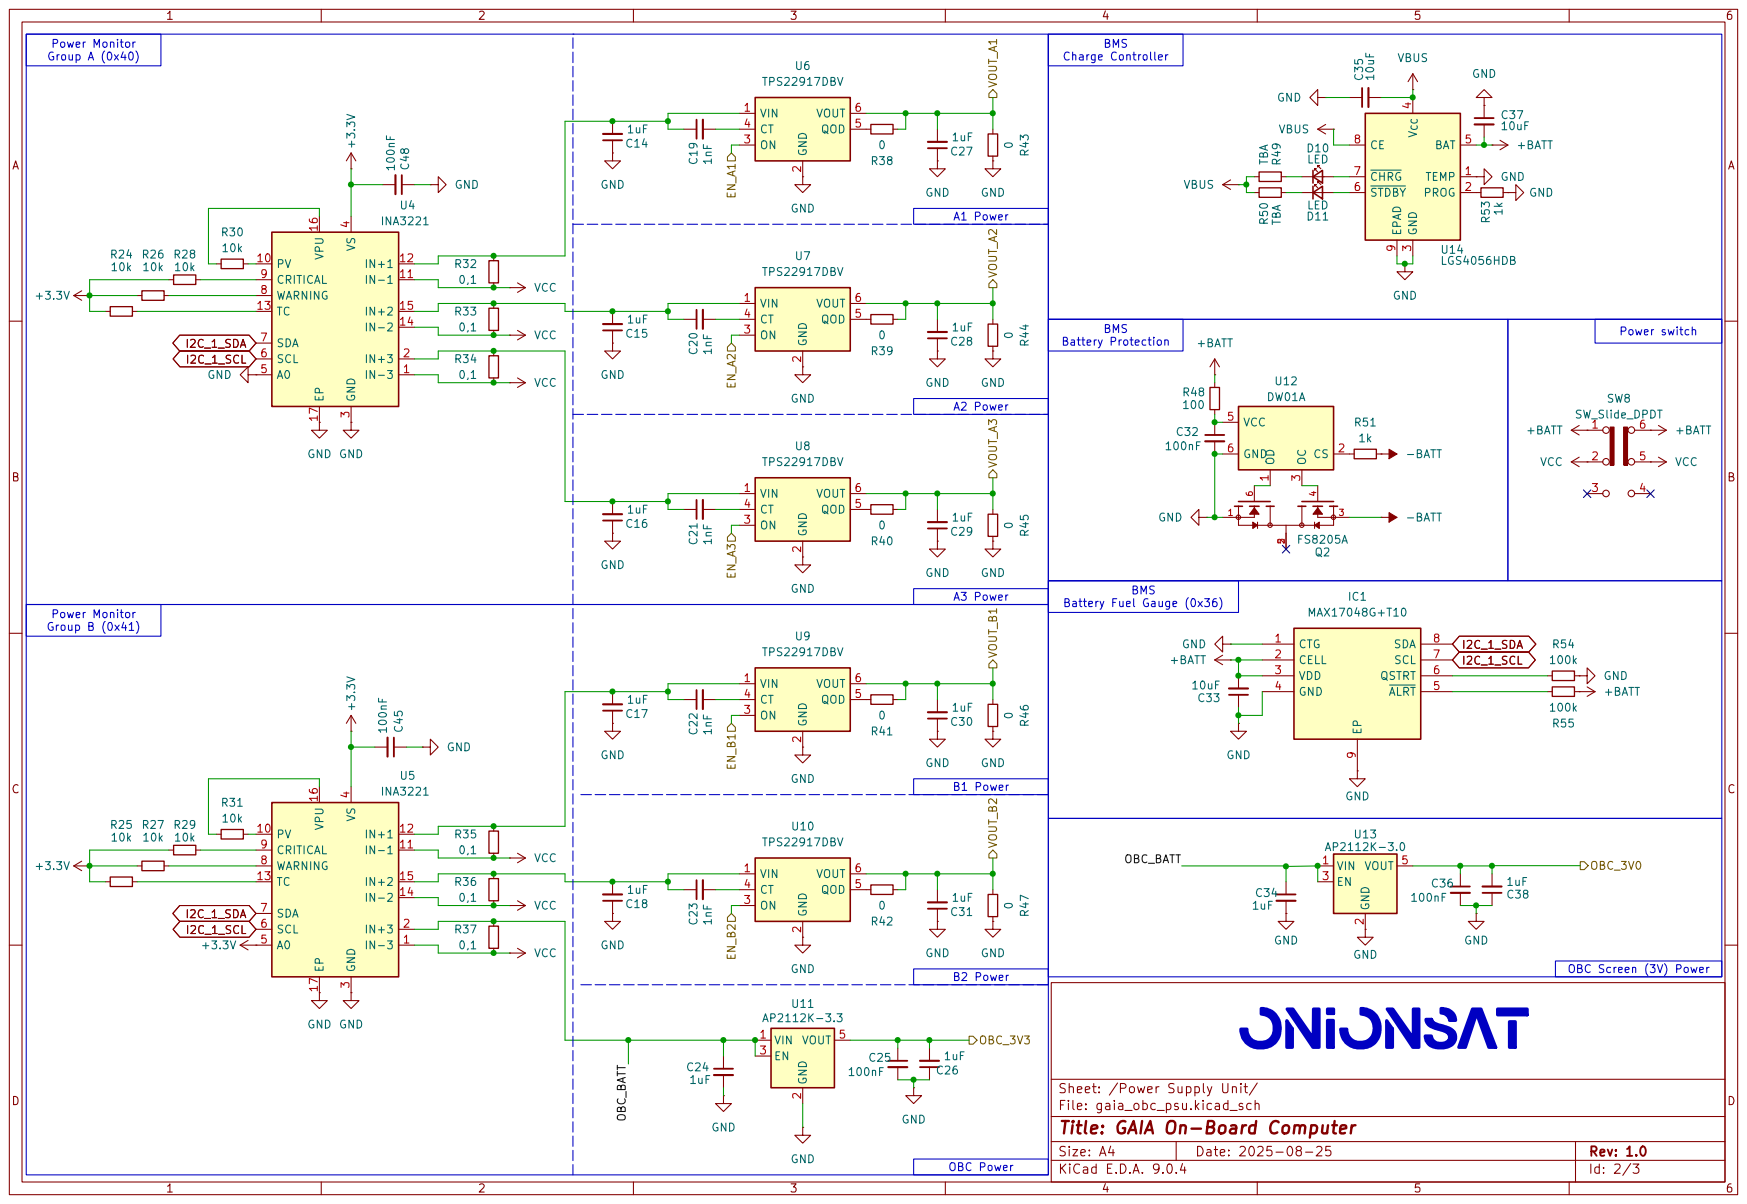
[picture p33: page 2]

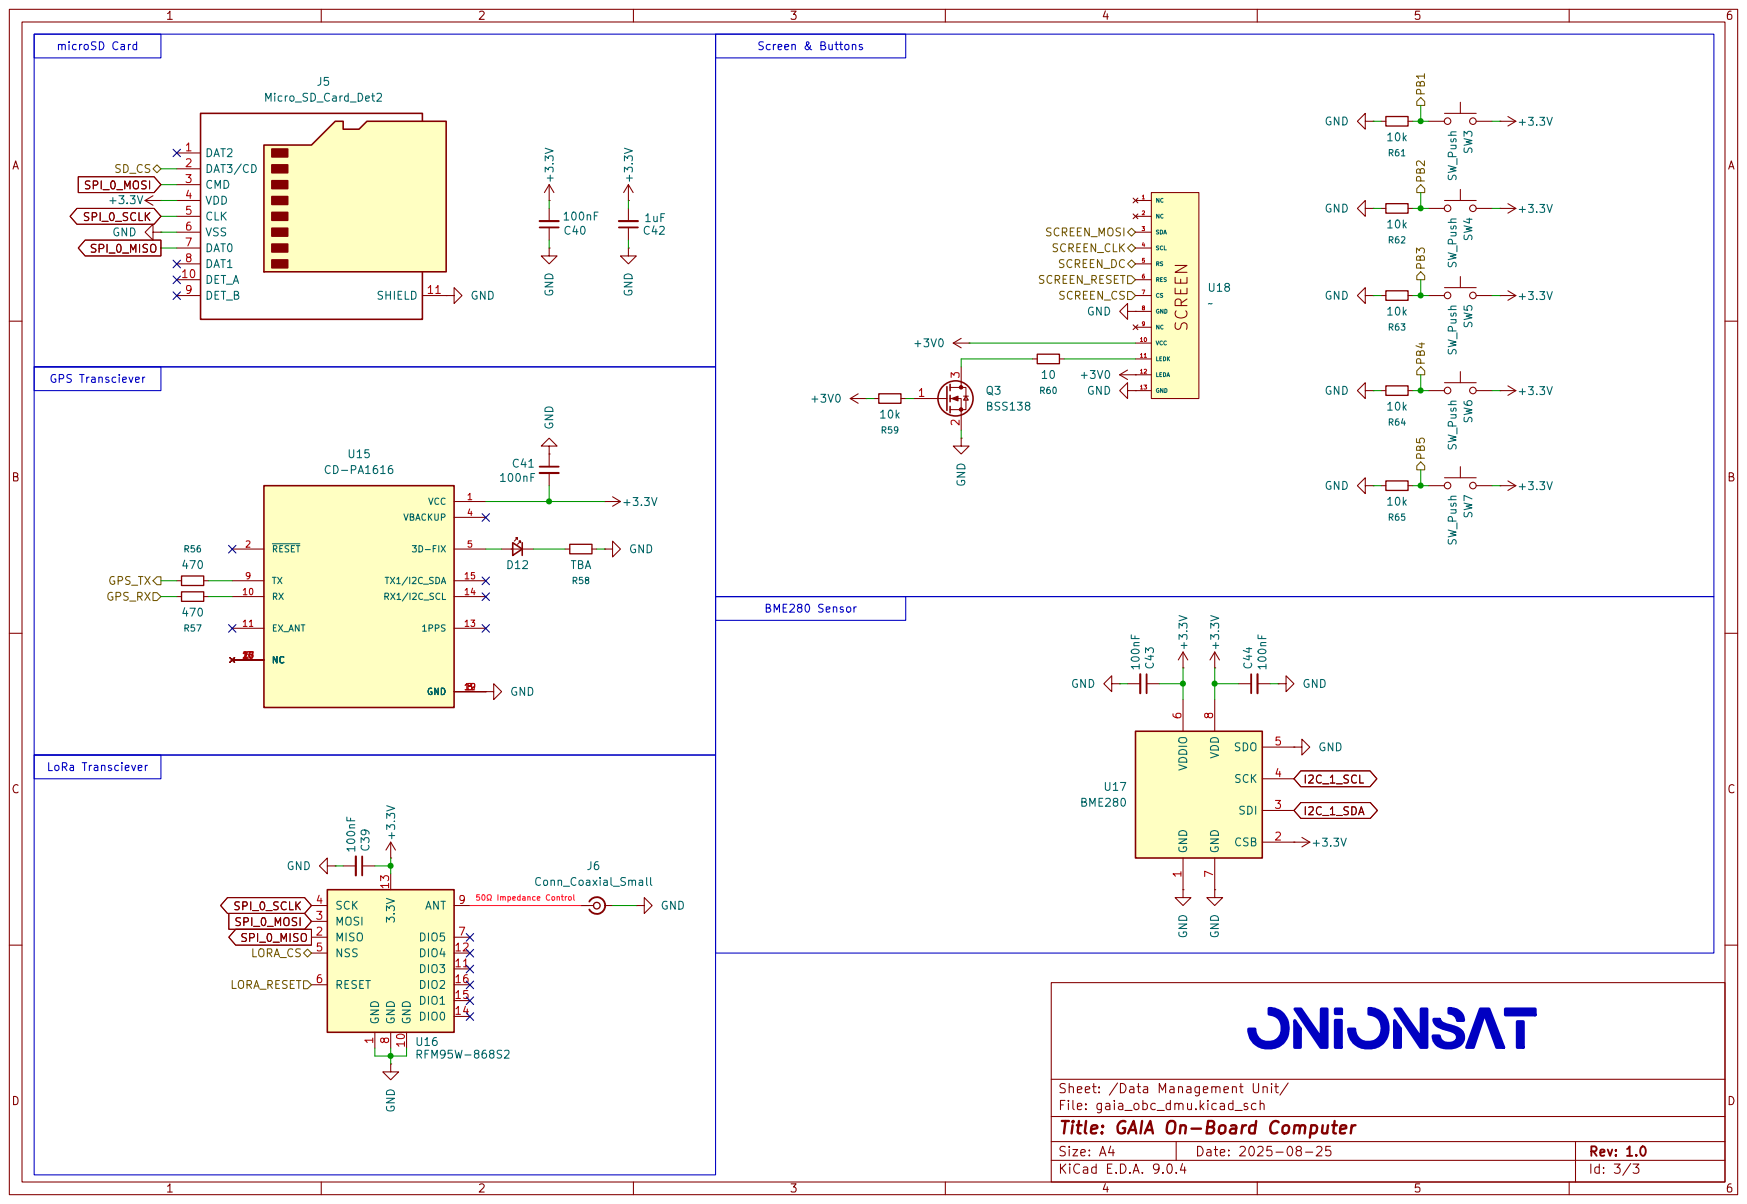
[picture p34: page 3]
