onionsat-pcbs/gaia-obc/gaia_obc.kicad_pcb

## KiCad design gaia_obc.kicad_pcb (2026-02-01)

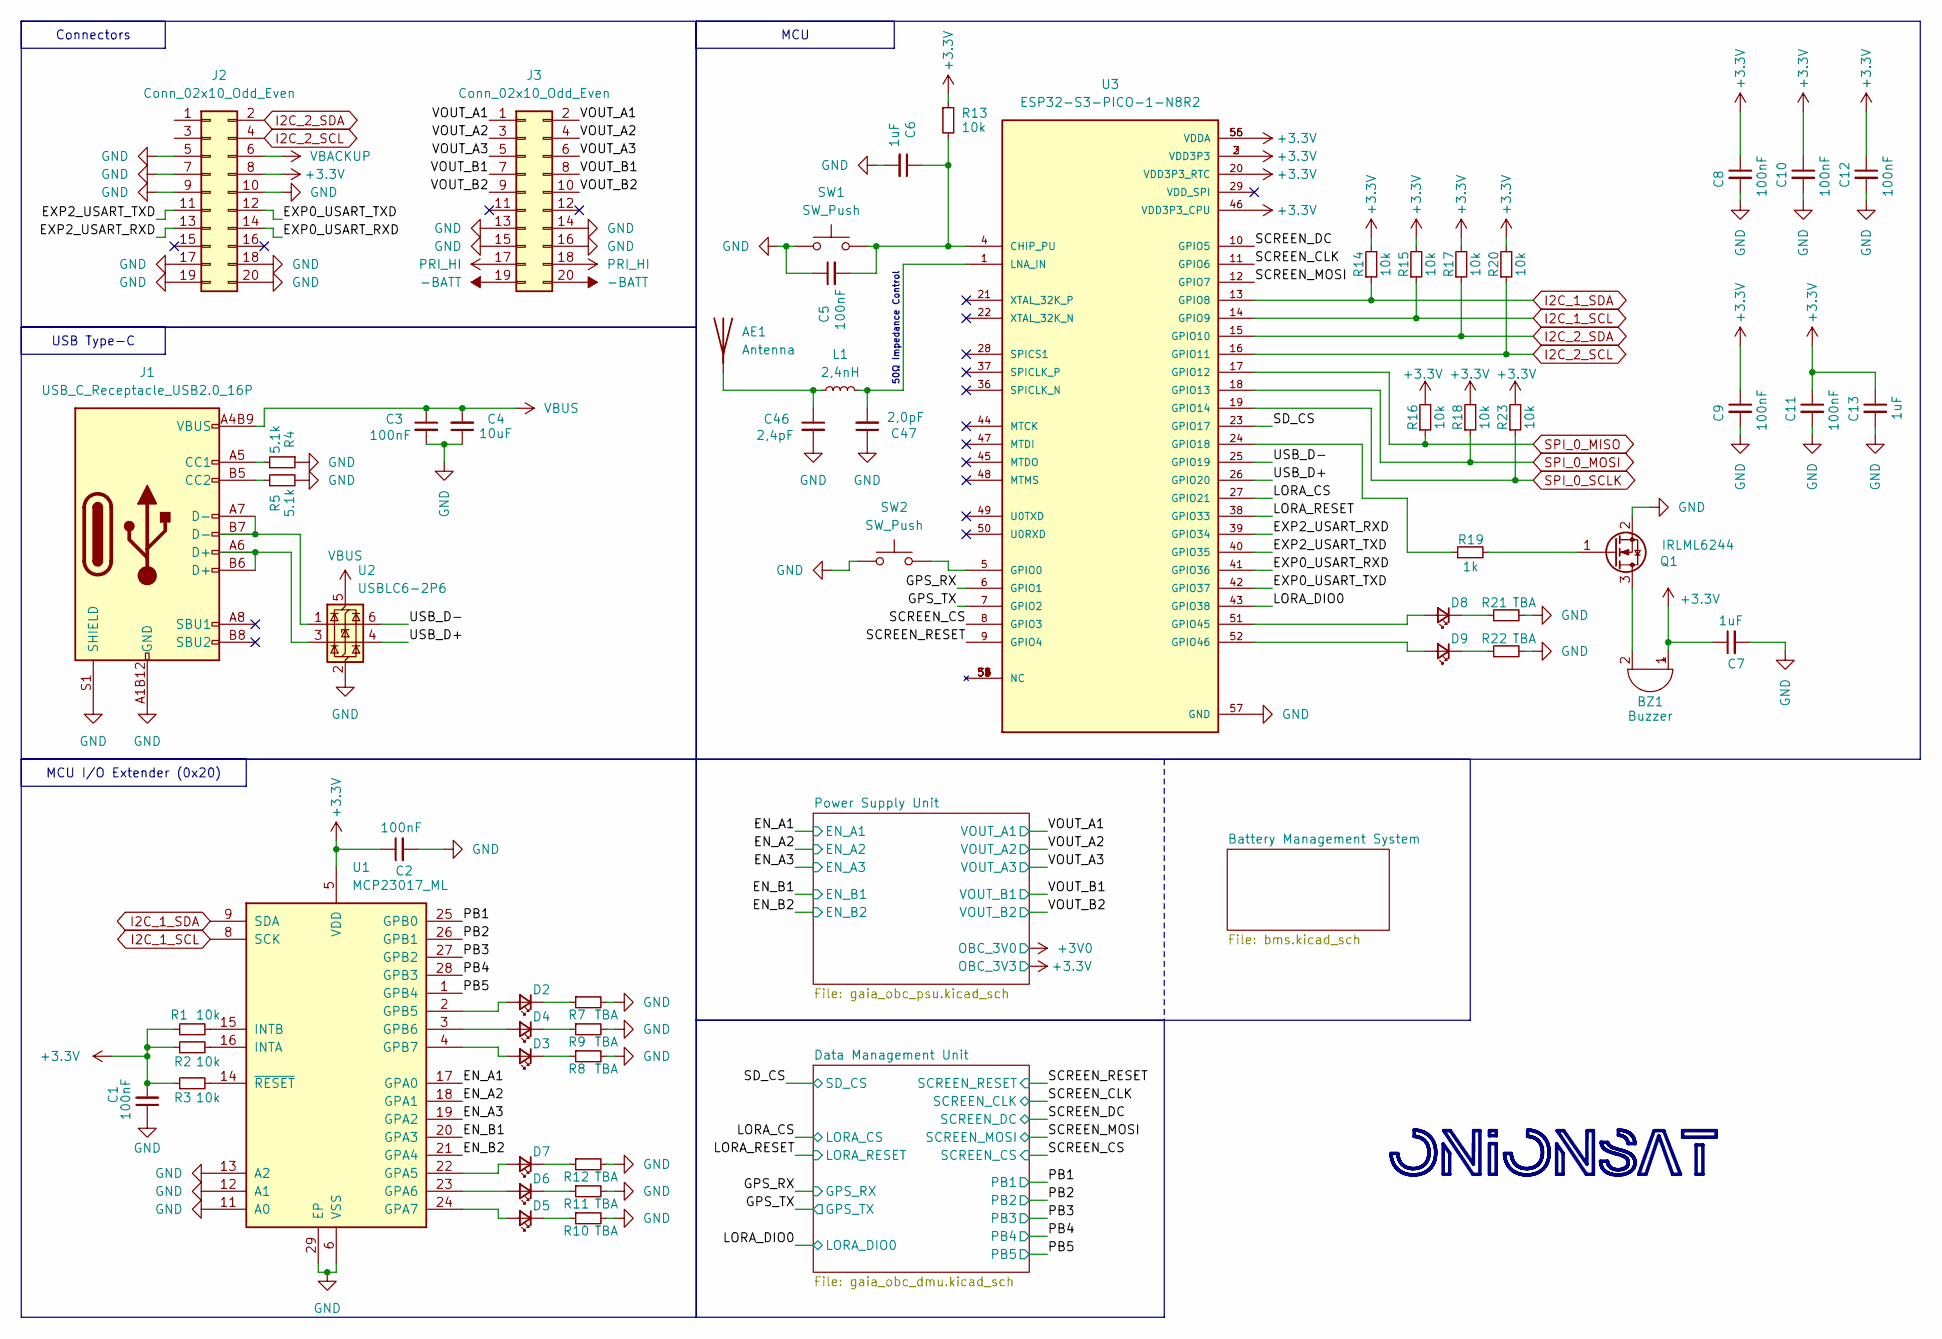
[picture p35: schematic gaia_obc.kicad_sch, Neptune On-Board Computer]

Parts:
AE1: Antenna; ANT-SMD_L8.0-W1.0
BZ1: Buzzer; buzzer_MLT-5020
C1, C2, C3, C5, C8, C9, C10, C11, C12: 100nF; C_0402_1005Metric
C4: 10uF; C_0603_1608Metric
C6, C7, C13: 1uF; C_0402_1005Metric
C46: 2,4pF; C_0402_1005Metric
C47: 2,0pF; C_0402_1005Metric
D2, D3, D4, D5, D6, D7, D8, D9: LED_Small; LED_0603_1608Metric
J1: USB_C_Receptacle_USB2.0_16P; USB-SMD_TYPE-C-16PQT-073
J2, J3: Conn_02x10_Odd_Even; PinHeader_2x10_P2.00mm_Vertical_SMD
L1: 2,4nH; L_0402_1005Metric
Q1: IRLML6244; SOT-23
R1, R2, R3, R13, R14, R15, R16, R17, R18, R20, R23: 10k; R_0402_1005Metric
R4, R5: 5.1k; R_0402_1005Metric
R7, R8, R9, R10, R11, R12, R21, R22: TBA; R_0402_1005Metric
R19: 1k; R_0402_1005Metric
SW1, SW2: SW_Push; KEY-SMD_L4.0-W3.0-LS4.9-1
U1: MCP23017_ML; QFN-28-1EP_6x6mm_P0.65mm_EP4.25x4.25mm
U2: USBLC6-2P6; SOT-666
U3: ESP32-S3-PICO-1-N8R2; PQFN40P700X700X106-57N; PARTREV 1.0

Connections:
+3.3V: BZ1.1 (+), C1.2, C2.1, C7.1, C8.1, C9.1, C10.1, C11.1, C12.1, C13.1, J2.8, R1.1, R2.1, R3.1, R13.1, R14.2, R15.2, R16.2, R17.2, R18.2, R20.2, R23.2, U1.5 (VDD), U3.2 (VDD3P3), U3.3 (VDD3P3), U3.20 (VDD3P3_RTC), U3.46 (VDD3P3_CPU), U3.55 (VDDA), U3.56 (VDDA); also elsewhere on the board
-BATT: J3.19, J3.20; also elsewhere on the board
/EN_A1: U1.17 (GPA0); also elsewhere on the board
/EN_A2: U1.18 (GPA1); also elsewhere on the board
/EN_A3: U1.19 (GPA2); also elsewhere on the board
/EN_B1: U1.20 (GPA3); also elsewhere on the board
/EN_B2: U1.21 (GPA4); also elsewhere on the board
/EXP0_USART_RXD: J2.14, U3.41 (GPIO36)
/EXP0_USART_TXD: J2.12, U3.42 (GPIO37)
/EXP2_USART_RXD: J2.13, U3.39 (GPIO34)
/EXP2_USART_TXD: J2.11, U3.40 (GPIO35)
/GPS_RX: U3.6 (GPIO1); also elsewhere on the board
/GPS_TX: U3.7 (GPIO2); also elsewhere on the board
/LORA_CS: U3.27 (GPIO21); also elsewhere on the board
/LORA_DIO0: U3.43 (GPIO38); also elsewhere on the board
/LORA_RESET: U3.38 (GPIO33); also elsewhere on the board
/PB1: U1.25 (GPB0); also elsewhere on the board
/PB2: U1.26 (GPB1); also elsewhere on the board
/PB3: U1.27 (GPB2); also elsewhere on the board
/PB4: U1.28 (GPB3); also elsewhere on the board
/PB5: U1.1 (GPB4); also elsewhere on the board
/SCREEN_CLK: U3.11 (GPIO6); also elsewhere on the board
/SCREEN_CS: U3.8 (GPIO3); also elsewhere on the board
/SCREEN_DC: U3.10 (GPIO5); also elsewhere on the board
/SCREEN_MOSI: U3.12 (GPIO7); also elsewhere on the board
/SCREEN_RESET: U3.9 (GPIO4); also elsewhere on the board
/SD_CS: U3.23 (GPIO17); also elsewhere on the board
/USB_D+: U2.4 (I/O2), U3.26 (GPIO20)
/USB_D-: U2.6 (I/O1), U3.25 (GPIO19)
/VOUT_A1: J3.1, J3.2; also elsewhere on the board
/VOUT_A2: J3.3, J3.4; also elsewhere on the board
/VOUT_A3: J3.5, J3.6; also elsewhere on the board
/VOUT_B1: J3.7, J3.8; also elsewhere on the board
/VOUT_B2: J3.9, J3.10; also elsewhere on the board
GND: C1.1, C2.2, C3.2, C4.1, C5.1, C6.2, C7.2, C8.2, C9.2, C10.2, C11.2, C12.2, C13.2, C46.2, C47.1, J1.A1B12 (GND), J1.B1A12 (GND), J1.S1 (SHIELD), J2.5, J2.7, J2.9, J2.10, J2.17, J2.18, J2.19, J2.20, J3.13, J3.14, J3.15, J3.16, Q1.2 (S), R4.1, R5.2, R7.2, R8.2, R9.2, R10.2, R11.2, R12.2, R21.2, R22.2, SW1.1, SW2.1, U1.6 (VSS), U1.11 (A0), U1.12 (A1), U1.13 (A2), U1.29 (EP), U2.2 (GND), U3.57 (GND); also elsewhere on the board
I2C_1_SCL: R15.1, U1.8 (SCK), U3.14 (GPIO9); also elsewhere on the board
I2C_1_SDA: R14.1, U1.9 (SDA), U3.13 (GPIO8); also elsewhere on the board
I2C_2_SCL: J2.4, R20.1, U3.16 (GPIO11)
I2C_2_SDA: J2.2, R17.1, U3.15 (GPIO10)
unnamed: AE1.1 (A), C46.1, L1.1
unnamed: BZ1.2 (-), Q1.3 (D)
unnamed: D2.2 (A), U1.2 (GPB5)
unnamed: D2.1 (K), R7.1
unnamed: D3.2 (A), U1.4 (GPB7)
unnamed: D3.1 (K), R8.1
unnamed: D4.2 (A), U1.3 (GPB6)
unnamed: D4.1 (K), R9.1
unnamed: D5.2 (A), U1.24 (GPA7)
unnamed: D5.1 (K), R10.1
unnamed: D6.2 (A), U1.23 (GPA6)
unnamed: D6.1 (K), R11.1
unnamed: D7.2 (A), U1.22 (GPA5)
unnamed: D7.1 (K), R12.1
unnamed: D8.2 (A), U3.51 (GPIO45)
unnamed: D8.1 (K), R21.1
unnamed: D9.2 (A), U3.52 (GPIO46)
unnamed: D9.1 (K), R22.1
unnamed: J1.A5 (CC1), R4.2
unnamed: J1.B5 (CC2), R5.1
unnamed: J1.A6 (D+), J1.B6 (D+), U2.3 (I/O2)
unnamed: J1.A7 (D-), J1.B7 (D-), U2.1 (I/O1)
unnamed: Q1.1 (G), R19.2
unnamed: R2.2, U1.16 (INTA)
unnamed: R1.2, U1.15 (INTB)
unnamed: R3.2, U1.14 (~RESET)
unnamed: C5.2, C6.1, R13.2, SW1.2, U3.4 (CHIP_PU)
unnamed: SW2.2, U3.5 (GPIO0)
unnamed: R19.1, U3.24 (GPIO18)
unnamed: C47.2, L1.2, U3.1 (LNA_IN)
PRI_HI: J3.17, J3.18; also elsewhere on the board
SPI_0_MISO: R16.1, U3.17 (GPIO12); also elsewhere on the board
SPI_0_MOSI: R18.1, U3.18 (GPIO13); also elsewhere on the board
SPI_0_SCLK: R23.1, U3.19 (GPIO14); also elsewhere on the board
VBACKUP: J2.6; also elsewhere on the board
VBUS: C3.1, C4.2, J1.A4B9 (VBUS), J1.B4A9 (VBUS), U2.5 (VBUS); also elsewhere on the board

Notes on the sheet:
50Ω Impedance Control
USB Type-C
Connectors
MCU
MCU I/O Extender (0x20)

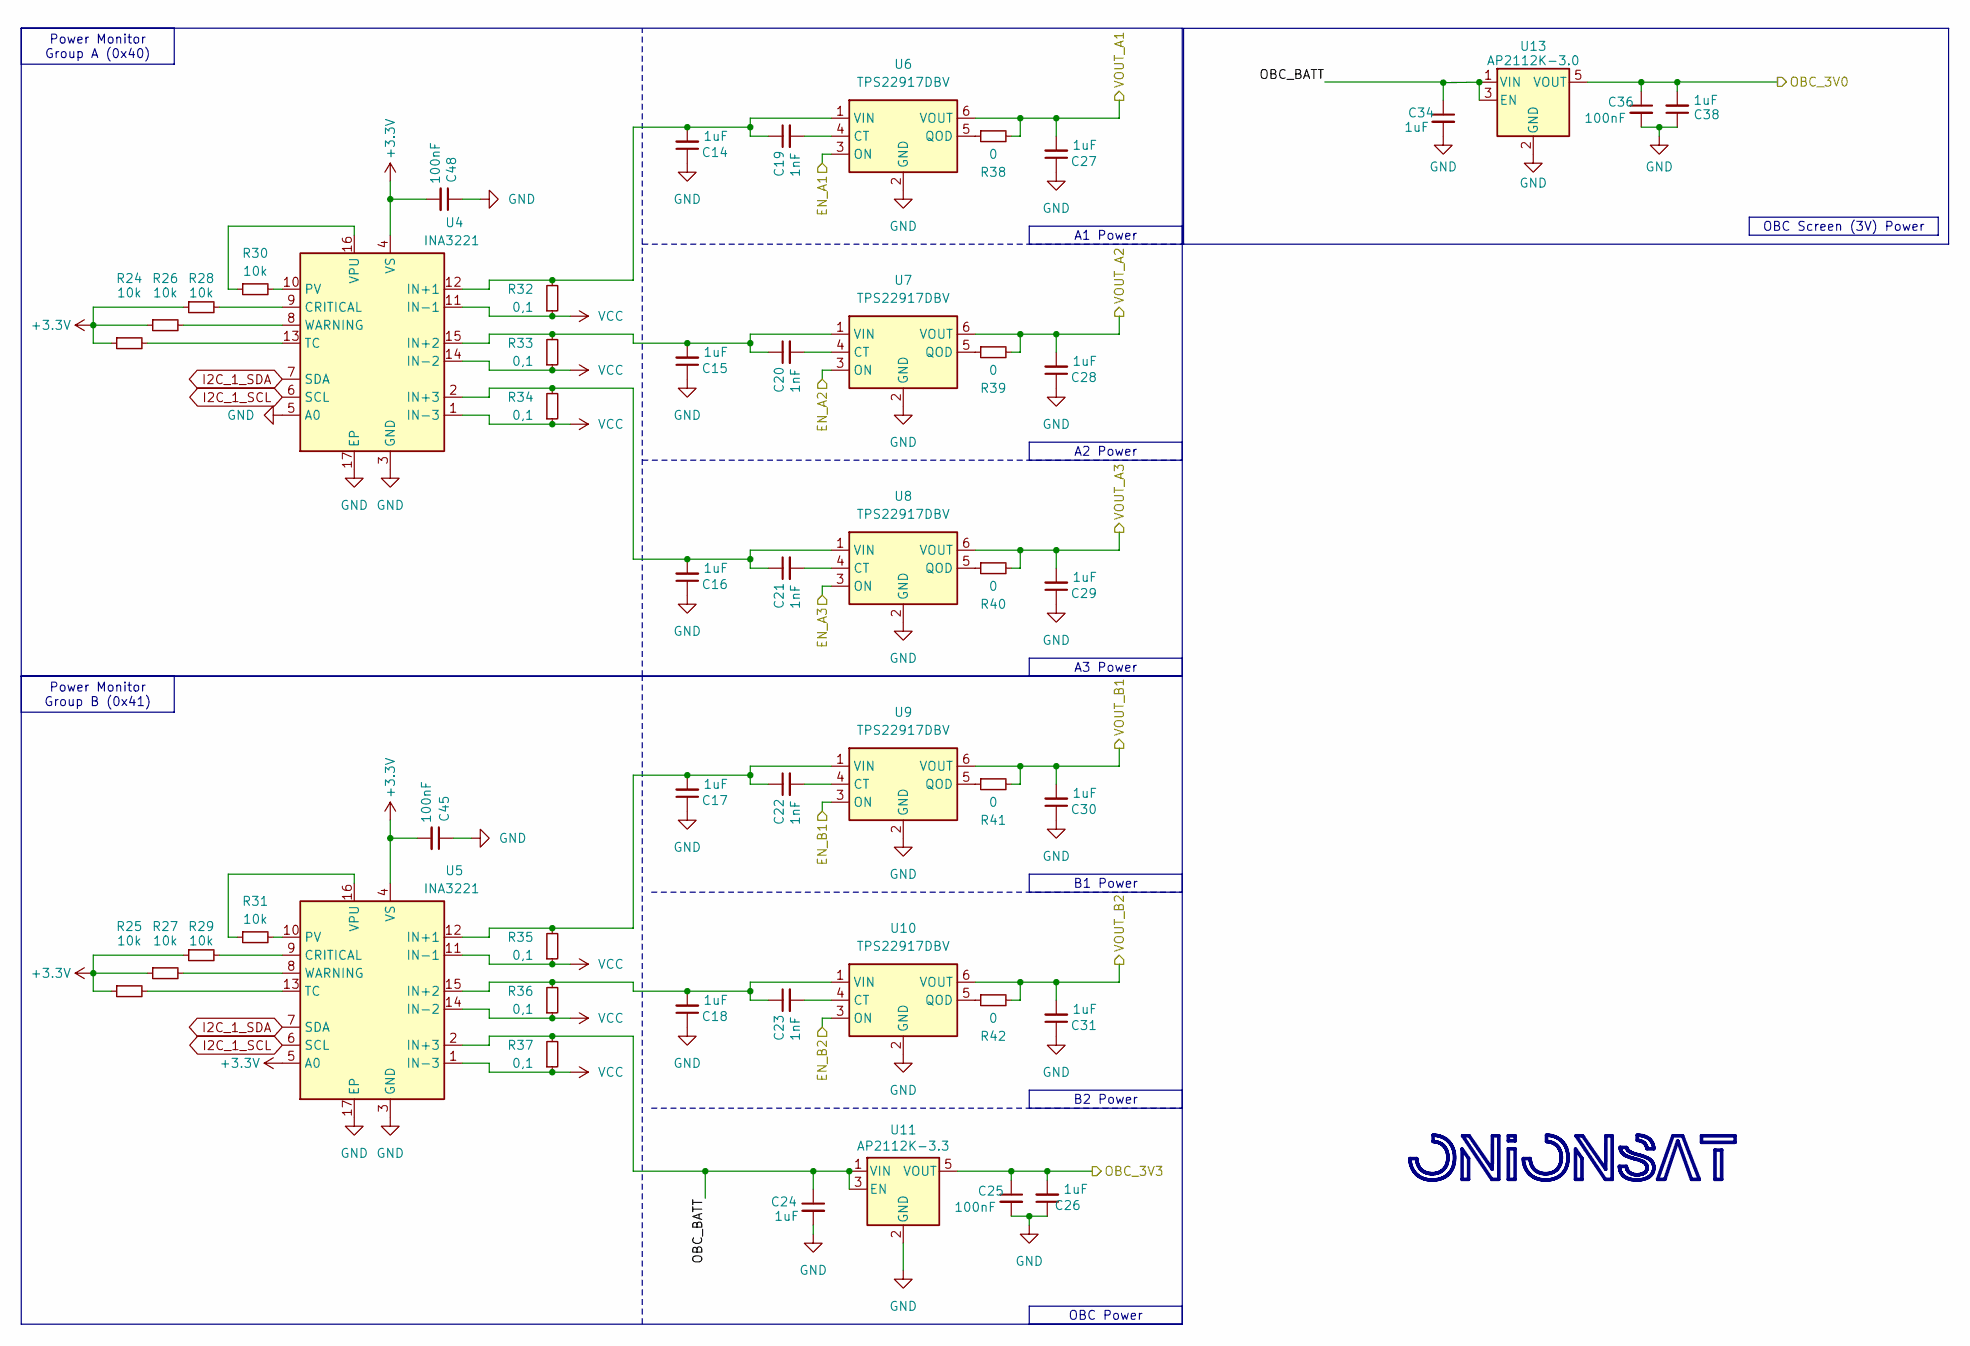
[picture p36: schematic gaia_obc_psu.kicad_sch, Neptune On-Board Computer]

Parts:
C14, C15, C16, C17, C18, C24, C26, C27, C28, C29, C30, C31, C34, C38: 1uF; C_0402_1005Metric
C19, C20, C21, C22, C23: 1nF; C_0402_1005Metric
C25, C36, C45, C48: 100nF; C_0402_1005Metric
R24, R25, R26, R27, R28, R29, R30, R31: 10k; R_0402_1005Metric
R32, R33, R34, R35, R36, R37: 0,1; R_1206_3216Metric
R38, R39, R40, R41, R42: 0; R_0402_1005Metric
U4, U5: INA3221; Texas_RGV0016A_VQFN-16-1EP_4x4mm_P0.65mm_EP2.1x2.1mm
U6, U7, U8, U9, U10: TPS22917DBV; SOT-23-6
U11: AP2112K-3.3; SOT-23-5
U13: AP2112K-3.0; SOT-23-5

Connections:
+3.3V: C25.1, C26.2, C45.2, C48.2, R24.1, R25.1, R26.1, R27.1, R28.1, R29.1, U4.4 (VS), U5.4 (VS), U5.5 (A0), U11.5 (VOUT); also elsewhere on the board
+3V0: C36.1, C38.2, U13.5 (VOUT); also elsewhere on the board
/EN_A1: U6.3 (ON); also elsewhere on the board
/EN_A2: U7.3 (ON); also elsewhere on the board
/EN_A3: U8.3 (ON); also elsewhere on the board
/EN_B1: U9.3 (ON); also elsewhere on the board
/EN_B2: U10.3 (ON); also elsewhere on the board
/Power Supply Unit/OBC_BATT: C24.1, C34.1, R37.2, U5.2 (IN+3), U11.1 (VIN), U11.3 (EN), U13.1 (VIN), U13.3 (EN)
/VOUT_A1: C27.2, R38.2, U6.6 (VOUT); also elsewhere on the board
/VOUT_A2: C28.2, R39.2, U7.6 (VOUT); also elsewhere on the board
/VOUT_A3: C29.2, R40.2, U8.6 (VOUT); also elsewhere on the board
/VOUT_B1: C30.2, R41.2, U9.6 (VOUT); also elsewhere on the board
/VOUT_B2: C31.2, R42.2, U10.6 (VOUT); also elsewhere on the board
GND: C14.1, C15.1, C16.1, C17.1, C18.1, C24.2, C25.2, C26.1, C27.1, C28.1, C29.1, C30.1, C31.1, C34.2, C36.2, C38.1, C45.1, C48.1, U4.3 (GND), U4.5 (A0), U4.17 (EP), U5.3 (GND), U5.17 (EP), U6.2 (GND), U7.2 (GND), U8.2 (GND), U9.2 (GND), U10.2 (GND), U11.2 (GND), U13.2 (GND); also elsewhere on the board
I2C_1_SCL: U4.6 (SCL), U5.6 (SCL); also elsewhere on the board
I2C_1_SDA: U4.7 (SDA), U5.7 (SDA); also elsewhere on the board
unnamed: R28.2, U4.9 (CRITICAL)
unnamed: C14.2, C19.1, R32.2, U4.12 (IN+1), U6.1 (VIN)
unnamed: C15.2, C20.1, R33.2, U4.15 (IN+2), U7.1 (VIN)
unnamed: C16.2, C21.1, R34.2, U4.2 (IN+3), U8.1 (VIN)
unnamed: R30.2, U4.10 (PV)
unnamed: R24.2, U4.13 (TC)
unnamed: R30.1, U4.16 (VPU)
unnamed: R26.2, U4.8 (WARNING)
unnamed: R29.2, U5.9 (CRITICAL)
unnamed: C17.2, C22.1, R35.2, U5.12 (IN+1), U9.1 (VIN)
unnamed: R31.2, U5.10 (PV)
unnamed: R25.2, U5.13 (TC)
unnamed: R31.1, U5.16 (VPU)
unnamed: R27.2, U5.8 (WARNING)
unnamed: C19.2, U6.4 (CT)
unnamed: R38.1, U6.5 (QOD)
unnamed: C20.2, U7.4 (CT)
unnamed: R39.1, U7.5 (QOD)
unnamed: C21.2, U8.4 (CT)
unnamed: R40.1, U8.5 (QOD)
unnamed: C22.2, U9.4 (CT)
unnamed: R41.1, U9.5 (QOD)
unnamed: C23.2, U10.4 (CT)
unnamed: R42.1, U10.5 (QOD)
unnamed: C18.2, C23.1, R36.2, U5.15 (IN+2), U10.1 (VIN)
VCC: R32.1, R33.1, R34.1, R35.1, R36.1, R37.1, U4.1 (IN-3), U4.11 (IN-1), U4.14 (IN-2), U5.1 (IN-3), U5.11 (IN-1), U5.14 (IN-2); also elsewhere on the board

Notes on the sheet:
A2 Power
A1 Power
B1 Power
OBC Power
Power Monitor Group A (0x40)
OBC Screen (3V) Power
B2 Power
A3 Power
Power Monitor Group B (0x41)

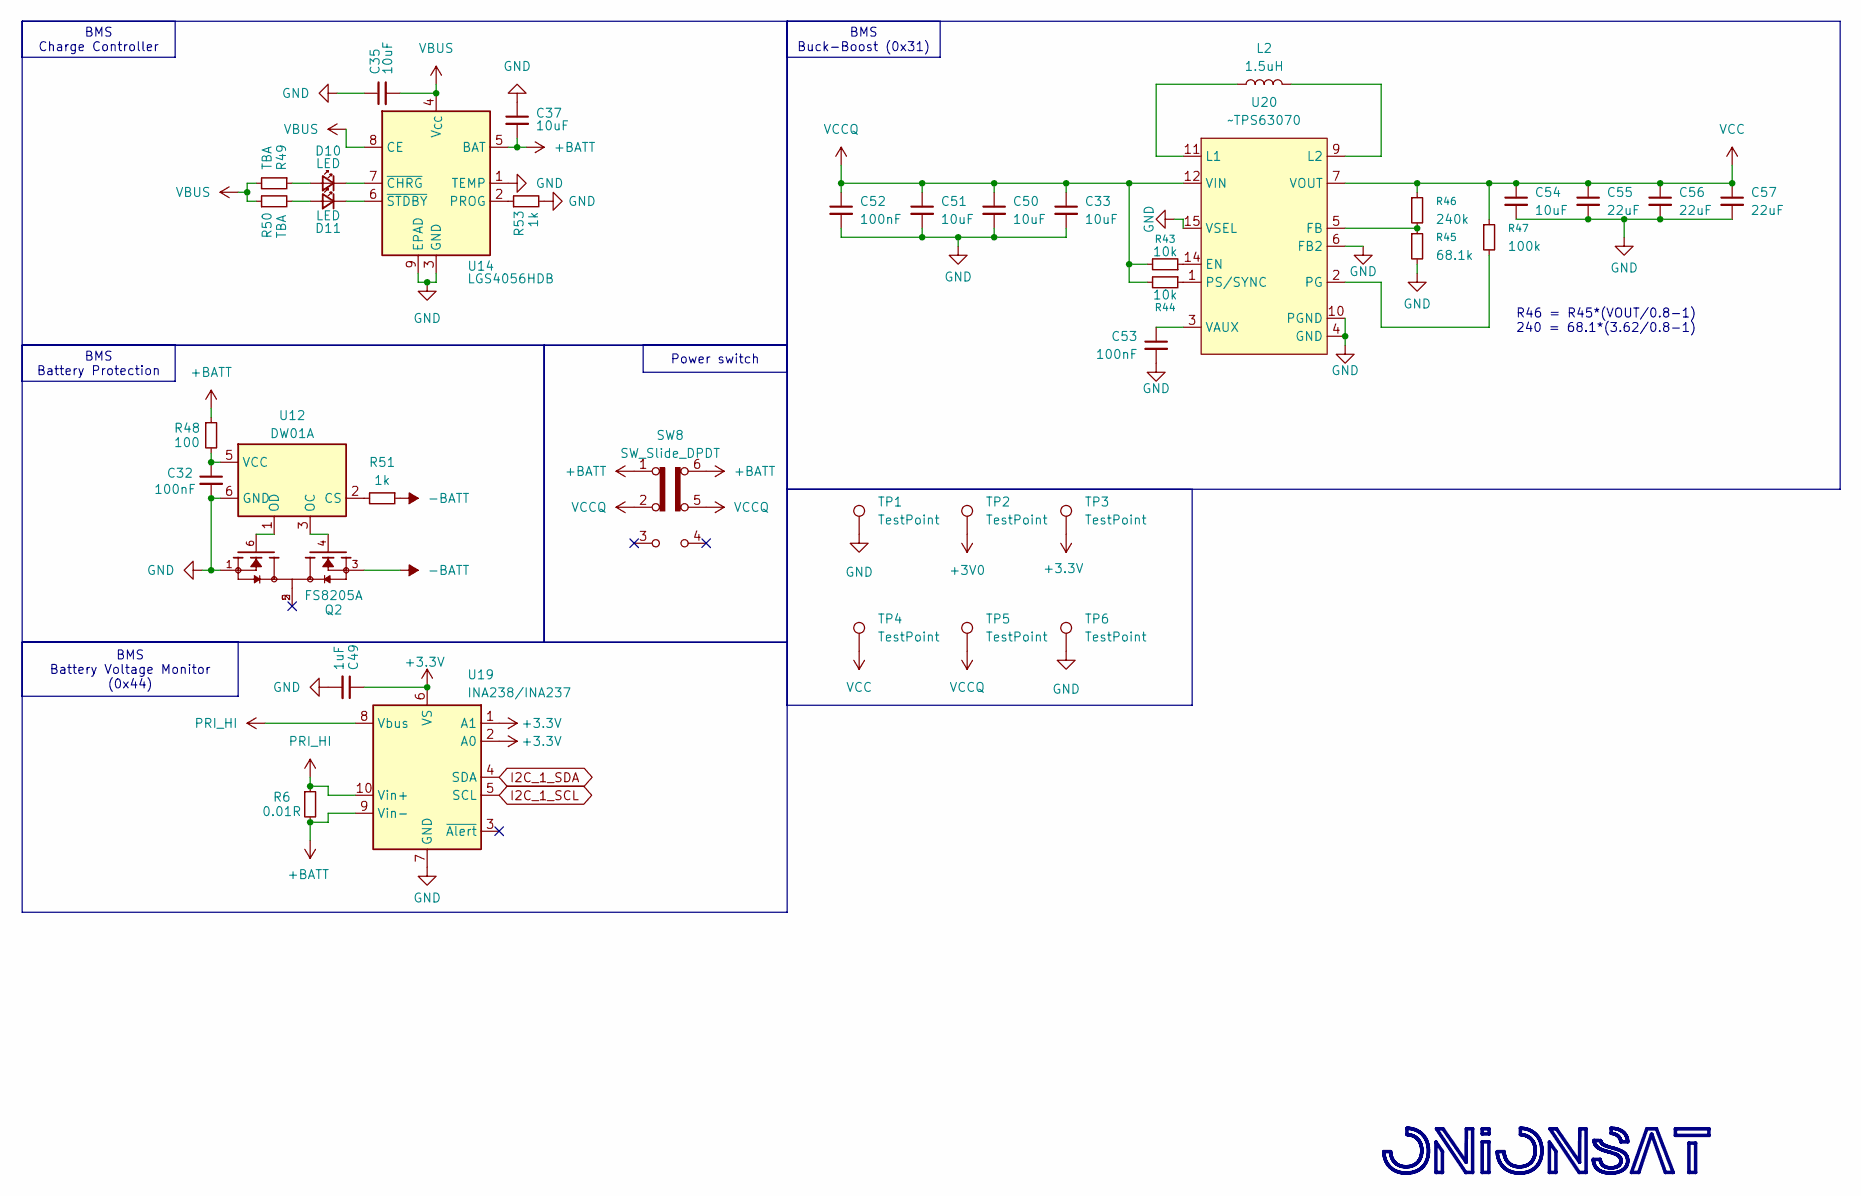
[picture p37: schematic bms.kicad_sch, Neptune On-Board Computer]

Parts:
C32: 100nF; C_0402_1005Metric
C33, C35, C37, C54: 10uF; C_0603_1608Metric
C49: 1uF; C_0603_1608Metric
C50, C51: 10uF; C_0805_2012Metric
C52, C53: 100nF; C_0603_1608Metric
C55, C56, C57: 22uF; C_0805_2012Metric
D10, D11: LED; LED_0805_2012Metric
L2: 1.5uH; XFL4020152MEC
Q2: FS8205A; SOT-23-6; PARTREV 1.7
R6: 0.01R; R_2512_6332Metric
R43, R44: 10k; R_0402_1005Metric
R45: 68.1k; R_0603_1608Metric
R46: 240k; R_0603_1608Metric
R47: 100k; R_0603_1608Metric
R48: 100; R_0603_1608Metric
R49, R50: TBA; R_0603_1608Metric
R51: 1k; R_0603_1608Metric
R53: 1k; R_0402_1005Metric
SW8: SW_Slide_DPDT; MS-22D28-G020
TP1, TP2, TP3, TP4, TP5, TP6: TestPoint; TestPoint_Pad_1.0x1.0mm
U12: DW01A; SOT-23-6
U14: LGS4056HDB; DFN-8-1EP_3x3mm_P0.65mm_EP1.55x2.4mm
U19: INA238/INA237; VSSOP-10_3x3mm_P0.5mm
U20: ~TPS63070; TPS630701RNMR

Connections:
+3.3V: C49.1, TP3.1, U19.1 (A1), U19.2 (A0), U19.6 (VS); also elsewhere on the board
+3V0: TP2.1; also elsewhere on the board
+BATT: C37.2, R6.2, R48.1, SW8.1 (A), SW8.6 (C), U14.5 (BAT), U19.9 (Vin-)
-BATT: Q2.3, R51.1; also elsewhere on the board
GND: C32.2, C33.2, C35.1, C37.1, C49.2, C50.2, C51.2, C52.2, C53.2, C54.2, C55.2, C56.2, C57.2, Q2.1, R45.2, R53.2, TP1.1, TP6.1, U12.6 (GND), U14.1 (TEMP), U14.3 (GND), U14.9 (EPAD), U19.7 (GND), U20.4 (GND), U20.6 (FB2), U20.10 (PGND), U20.15 (VSEL); also elsewhere on the board
I2C_1_SCL: U19.5 (SCL); also elsewhere on the board
I2C_1_SDA: U19.4 (SDA); also elsewhere on the board
unnamed: D10.2 (A), R49.1
unnamed: D10.1 (K), U14.7 (~CHRG)
unnamed: D11.2 (A), R50.2
unnamed: D11.1 (K), U14.6 (~STDBY)
unnamed: R51.2, U12.2 (CS)
unnamed: Q2.4, U12.3 (OC)
unnamed: Q2.6, U12.1 (OD)
unnamed: C32.1, R48.2, U12.5 (VCC)
unnamed: R53.1, U14.2 (PROG)
unnamed: R43.1, U20.14 (EN)
unnamed: R45.1, R46.2, U20.5 (FB)
unnamed: L2.1, U20.11 (L1)
unnamed: L2.2, U20.9 (L2)
unnamed: R47.2, U20.2 (PG)
unnamed: R44.1, U20.1 (PS/SYNC)
unnamed: C53.1, U20.3 (VAUX)
PRI_HI: R6.1, U19.8 (Vbus), U19.10 (Vin+); also elsewhere on the board
VBUS: C35.2, R49.2, R50.1, U14.4 (V_{CC}), U14.8 (CE); also elsewhere on the board
VCC: C54.1, C55.1, C56.1, C57.1, R46.1, R47.1, TP4.1, U20.7 (VOUT); also elsewhere on the board
VCCQ: C33.1, C50.1, C51.1, C52.1, R43.2, R44.2, SW8.2 (B), SW8.5 (B), TP5.1, U20.12 (VIN)

Notes on the sheet:
R46 = R45*(VOUT/0.8-1) 240 = 68.1*(3.62/0.8-1)
BMS Buck-Boost (0x31)
BMS Charge Controller
BMS Battery Voltage Monitor (0x44)
Power switch
BMS Battery Protection

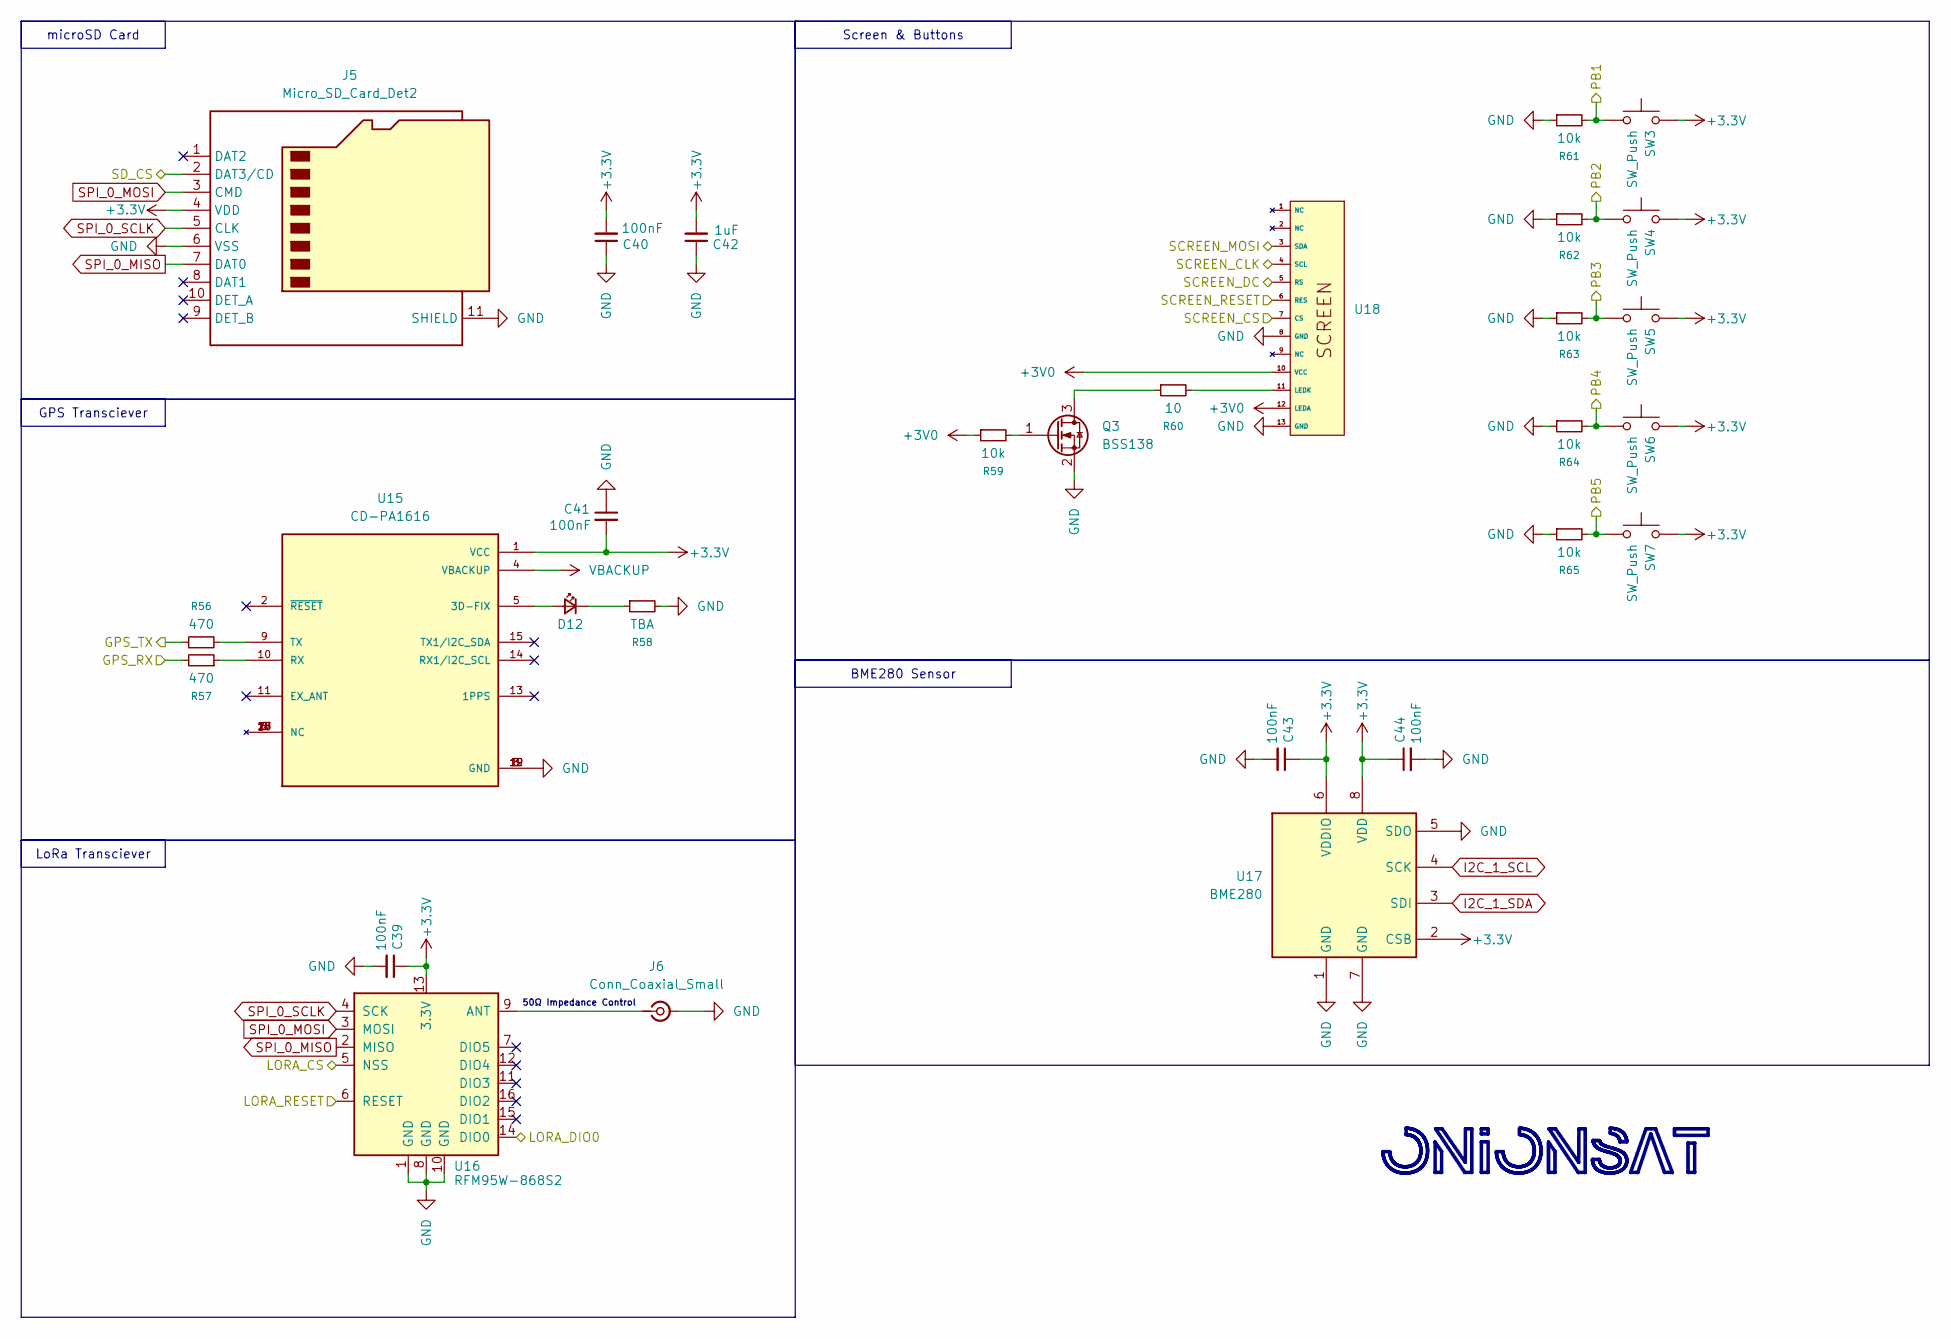
[picture p38: schematic gaia_obc_dmu.kicad_sch, Neptune On-Board Computer]

Parts:
C39, C40, C41, C43, C44: 100nF; C_0402_1005Metric
C42: 1uF; C_0402_1005Metric
D12: LED_Small; LED_0603_1608Metric
J5: Micro_SD_Card_Det2; microSD_HC_Hirose_DM3D-SF
J6: Conn_Coaxial_Small; U.FL_Hirose_U.FL-R-SMT-1_Vertical
Q3: BSS138; SOT-23
R56, R57: 470; R_0402_1005Metric
R58: TBA; R_0402_1005Metric
R59, R61, R62, R63, R64, R65: 10k; R_0402_1005Metric
R60: 10; R_0603_1608Metric
SW3, SW4, SW5, SW6, SW7: SW_Push; KEY-SMD_4P-L3.1-W3.1-P2.00-LS4.0
U15: CD-PA1616; XCVR_CD-PA1616D; PARTREV V.06
U16: RFM95W-868S2; HOPERF_RFM9XW_SMD
U17: BME280; Bosch_LGA-8_2.5x2.5mm_P0.65mm_ClockwisePinNumbering
U18: OLED-SMD_ST7735S

Connections:
+3.3V: C39.1, C40.2, C41.2, C42.2, C43.1, C44.1, J5.4 (VDD), SW3.2, SW4.2, SW5.2, SW6.2, SW7.2, U15.1 (VCC), U16.13 (3.3V), U17.2 (CSB), U17.6 (VDDIO), U17.8 (VDD); also elsewhere on the board
+3V0: R59.1, U18.10 (VCC), U18.12 (LEDA); also elsewhere on the board
/GPS_RX: R57.2; also elsewhere on the board
/GPS_TX: R56.1; also elsewhere on the board
/LORA_CS: U16.5 (NSS); also elsewhere on the board
/LORA_DIO0: U16.14 (DIO0); also elsewhere on the board
/LORA_RESET: U16.6 (RESET); also elsewhere on the board
/PB1: R61.2, SW3.1; also elsewhere on the board
/PB2: R62.2, SW4.1; also elsewhere on the board
/PB3: R63.2, SW5.1; also elsewhere on the board
/PB4: R64.2, SW6.1; also elsewhere on the board
/PB5: R65.2, SW7.1; also elsewhere on the board
/SCREEN_CLK: U18.4 (SCL); also elsewhere on the board
/SCREEN_CS: U18.7 (CS); also elsewhere on the board
/SCREEN_DC: U18.5 (RS); also elsewhere on the board
/SCREEN_MOSI: U18.3 (SDA); also elsewhere on the board
/SCREEN_RESET: U18.6 (RES); also elsewhere on the board
/SD_CS: J5.2 (DAT3/CD); also elsewhere on the board
GND: C39.2, C40.1, C41.1, C42.1, C43.2, C44.2, J5.6 (VSS), J5.11 (SHIELD), J6.2 (Ext), Q3.2 (S), R58.2, R61.1, R62.1, R63.1, R64.1, R65.1, U15.3 (GND), U15.8 (GND), U15.12 (GND), U15.19 (GND), U16.1 (GND), U16.8 (GND), U16.10 (GND), U17.1 (GND), U17.5 (SDO), U17.7 (GND), U18.8 (GND), U18.13 (GND); also elsewhere on the board
I2C_1_SCL: U17.4 (SCK); also elsewhere on the board
I2C_1_SDA: U17.3 (SDI); also elsewhere on the board
unnamed: D12.2 (A), U15.5 (3D-FIX)
unnamed: D12.1 (K), R58.1
unnamed: J6.1 (In), U16.9 (ANT)
unnamed: Q3.3 (D), R60.1
unnamed: Q3.1 (G), R59.2
unnamed: R57.1, U15.10 (RX)
unnamed: R56.2, U15.9 (TX)
unnamed: R60.2, U18.11 (LEDK)
SPI_0_MISO: J5.7 (DAT0), U16.2 (MISO); also elsewhere on the board
SPI_0_MOSI: J5.3 (CMD), U16.3 (MOSI); also elsewhere on the board
SPI_0_SCLK: J5.5 (CLK), U16.4 (SCK); also elsewhere on the board
VBACKUP: U15.4 (VBACKUP); also elsewhere on the board

Notes on the sheet:
50Ω Impedance Control
Screen & Buttons
BME280 Sensor
microSD Card
GPS Transciever
LoRa Transciever

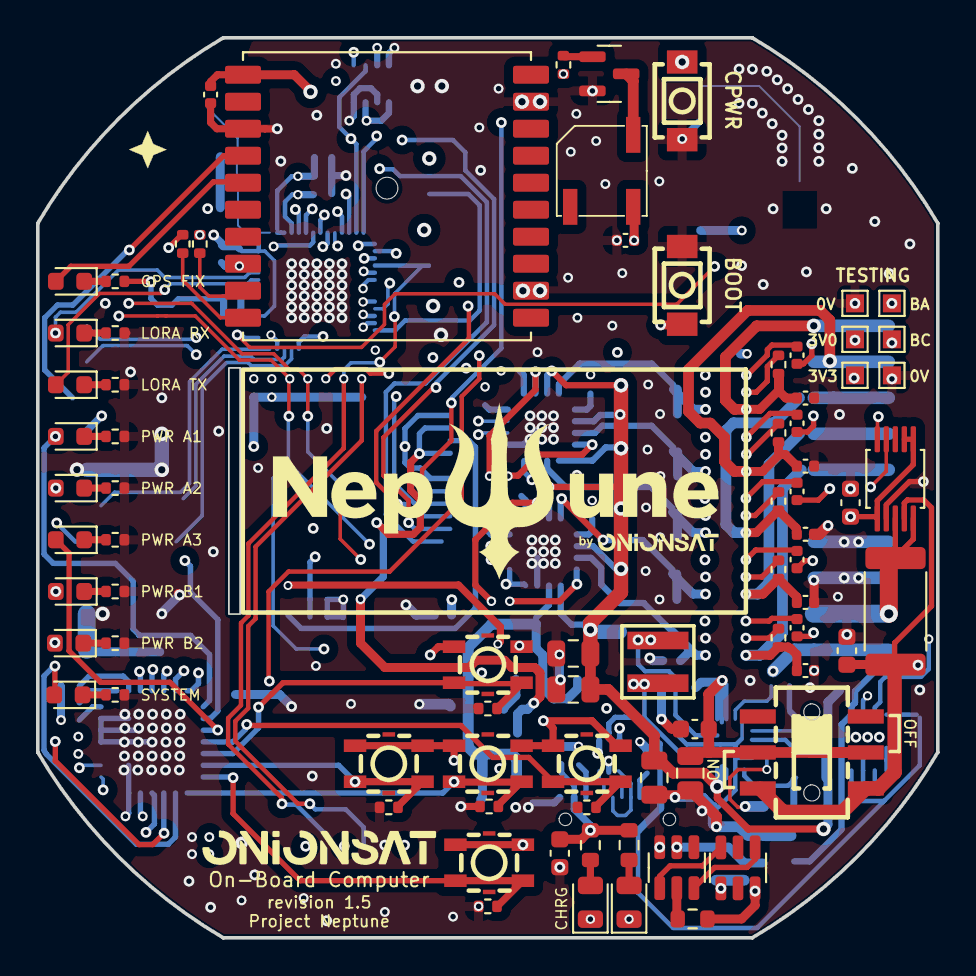
[picture p39: board gaia_obc.kicad_pcb from above]

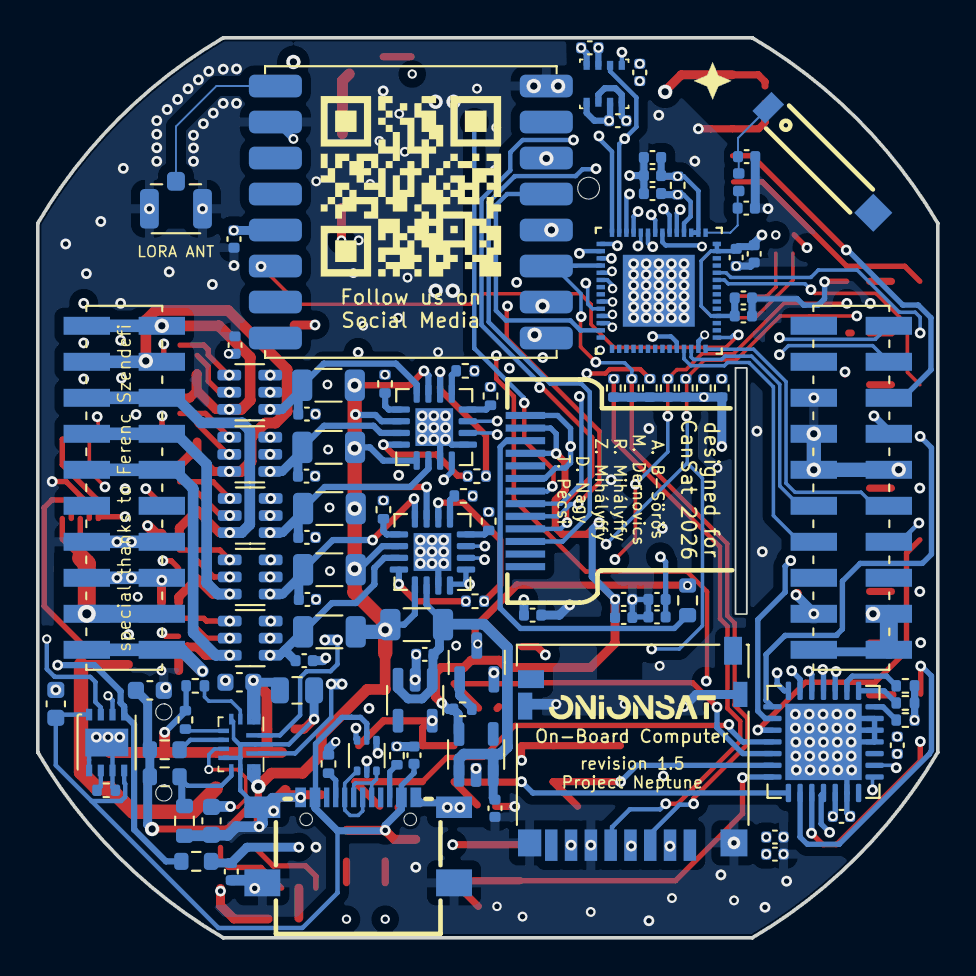
[picture p40: board gaia_obc.kicad_pcb from below]

Board: 8 copper layers, 50.0 x 50.0 mm, 176 parts (97 on the bottom side), 129 nets.
