onionsat-pcbs/gaia-obc/(commit log)

2025-05-28 initial release
    [gaia_obc.kicad_pcb, gaia_obc.kicad_sch]
2025-06-02 creating different sheets
    [gaia_obc.kicad_sch, gaia_obc_dmu.kicad_sch, gaia_obc_psu.kicad_sch]
2025-06-02 preparing ina3221
    [gaia_obc.kicad_pcb, gaia_obc_psu.kicad_sch]
2025-06-03 creating psu switches
    [gaia_obc.kicad_pcb, gaia_obc_psu.kicad_sch]
2025-06-03 finishing psu
    [gaia_obc.kicad_pcb, gaia_obc_dmu.kicad_sch, gaia_obc_psu.kicad_sch]
2025-06-25 borad outline
    [gaia_obc.kicad_pcb, outline.dxf]
2025-07-22 almost final release
    [gaia_obc.kicad_pcb, gaia_obc.kicad_sch, gaia_obc_dmu.kicad_sch, gaia_obc_psu.kicad_sch]
2025-08-01 prep for routing 2/1
    [gaia_obc.kicad_pcb, gaia_obc.kicad_sch, gaia_obc_dmu.kicad_sch, gaia_obc_psu.kicad_sch]
2025-08-03 almost routeable//98% done schema
    [gaia_obc.kicad_pcb, gaia_obc.kicad_sch, gaia_obc_dmu.kicad_sch, gaia_obc_psu.kicad_sch]
2025-08-04 start routing
    [gaia_obc.kicad_pcb, gaia_obc_dmu.kicad_sch]
2025-08-05 Keepout(slidein place) added to User.4 layer
    [gaia_obc.kicad_pcb]
2025-08-05 ready for approval
    [gaia_obc_psu.kicad_sch]
2025-08-07 change screen
    [gaia_obc.kicad_pcb, gaia_obc.kicad_sch, gaia_obc_dmu.kicad_sch]
2025-08-09 Finalizing schematic+Start placing components
    [gaia_obc.kicad_pcb, gaia_obc.kicad_sch, gaia_obc_dmu.kicad_sch, gaia_obc_psu.kicad_sch]
2025-08-10 finish placing components+small fixes in schema
    [gaia_obc.kicad_pcb, gaia_obc_dmu.kicad_sch, gaia_obc_psu.kicad_sch]
2025-08-17 ROUTING 1/3
    [gaia_obc.kicad_pcb]
2025-08-24 ROUTING DONE 08. 24.
    [gaia_obc.kicad_pcb, gaia_obc.kicad_sch, gaia_obc_psu.kicad_sch]
2025-08-24 fixing minor bugs
    [gaia_obc.kicad_pcb]
2025-08-24 cleaning up footprints + fixing DRC
    [gaia_obc.kicad_pcb]
2025-08-25 finalizing everything + creating stencil + ORDER 08. 25.
    [gaia-obc-stencil.kicad_pcb, gaia-obc-stencil.kicad_sch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]
2025-08-25 fixing stencil
    [gaia-obc-stencil.kicad_pcb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]
2025-08-26 Cleaning up schematics
    [gaia_obc.kicad_sch, gaia_obc_dmu.kicad_sch, gaia_obc_psu.kicad_sch]
2025-08-26 fixing BME280 position schematic
    [gaia_obc_dmu.kicad_sch]
2025-08-26 exporting schematic to PDF
2025-11-05 fixing bugs v1.1-pre1
    [gaia_obc.kicad_pcb, gaia_obc.kicad_sch, gaia_obc_psu.kicad_sch]
2025-11-06 fixing ANT bug v1.1-pre2
    [gaia_obc.kicad_pcb, gaia_obc_dmu.kicad_sch]
2025-11-06 Revert "fixing ANT bug v1.1-pre2"
    This reverts commit 9e563c6fd1f1bf527dff48955dff4f9202e18023.
    [gaia_obc.kicad_pcb, gaia_obc_dmu.kicad_sch]
2025-11-06 fixing routing problems v1.1-pre3
    [gaia_obc.kicad_pcb]
2025-11-07 v1.1-pre4 - fixing capacitors, ANT connector, optimizing routes
    [gaia_obc.kicad_pcb, gaia_obc.kicad_sch, gaia_obc_dmu.kicad_sch, gaia_obc_psu.kicad_sch]
2025-11-09 v1.1-final - production
    [gaia_obc-3V3.gbr, gaia_obc-B_Cu.gbr, gaia_obc-B_Mask.gbr, gaia_obc-B_Paste.gbr, gaia_obc-B_Silkscreen.gbr, gaia_obc-Edge_Cuts.gbr, gaia_obc-F_Cu.gbr, gaia_obc-F_Mask.gbr]
2025-11-09 adding position star
    [gaia_obc-3V3.gbr, gaia_obc-B_Cu.gbr, gaia_obc-B_Mask.gbr, gaia_obc-B_Paste.gbr, gaia_obc-B_Silkscreen.gbr, gaia_obc-Edge_Cuts.gbr, gaia_obc-F_Cu.gbr, gaia_obc-F_Mask.gbr]
2025-11-10 fixing infill stroke
    [gaia_obc-3V3.gbr, gaia_obc-B_Cu.gbr, gaia_obc-B_Mask.gbr, gaia_obc-B_Paste.gbr, gaia_obc-B_Silkscreen.gbr, gaia_obc-Edge_Cuts.gbr, gaia_obc-F_Cu.gbr, gaia_obc-F_Mask.gbr]
2025-12-01 obc v1.2-pre1
    [BME280.STEP, BUZ-SMD_3P-L5.0-W5.0-H2.0-P3.50.step, CD-PA1616D.STEP, ESP32-S3-PICO-1-N8R2.STEP, INA3221.STEP, KEY-SMD_4P-L3.1-W3.1-P2.00-LS4.0.step, KEY-SMD_L4.0-W3.0-LS4.9.step, MAX17048G-T10.STEP]
2025-12-01 adding logos + generating production files
    [gaia_obc-3V3.gbr, gaia_obc-B_Cu.gbr, gaia_obc-B_Mask.gbr, gaia_obc-B_Paste.gbr, gaia_obc-B_Silkscreen.gbr, gaia_obc-Edge_Cuts.gbr, gaia_obc-F_Cu.gbr, gaia_obc-F_Mask.gbr]
2025-12-12 neptune 1.3 production
    [bms.kicad_sch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]
2025-12-28 v1.4 - adding interrupt for lora
    [bms.kicad_sch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]
2025-12-30 BGA pad size fix v1.4.1
    [MAX77816AEWP_T.step, bms.kicad_sch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]
2026-02-01 obc v1.5
    [TFM201610GHM-1R0MTAA.stp, bms.kicad_sch, gaia_obc.kicad_pcb, gaia_obc.kicad_sch]
2026-02-01 Fixing INA238 VBUS err
    [bms.kicad_sch, gaia_obc.kicad_pcb]
2026-02-01 v1.5 - PROD
    [gaia_obc-3V3.gbr, gaia_obc-B_Cu.gbr, gaia_obc-B_Mask.gbr, gaia_obc-B_Paste.gbr, gaia_obc-B_Silkscreen.gbr, gaia_obc-Edge_Cuts.gbr, gaia_obc-F_Cu.gbr, gaia_obc-F_Mask.gbr]
